yosihisa/WaterRocketComputerVer4/基板/製造ファイル/Specified requirement.docx

# Specified requirement

1. Do not Solder

Do not solder the red pad in the figure below.

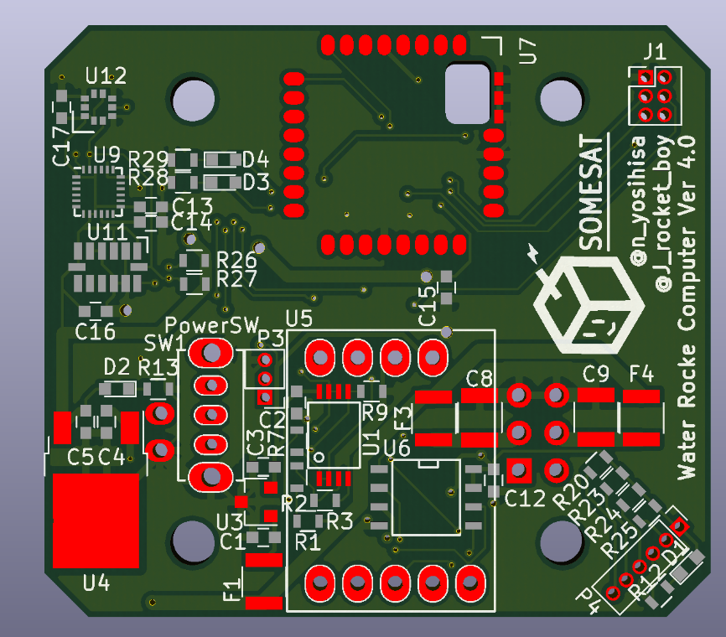
[picture p1: figure]
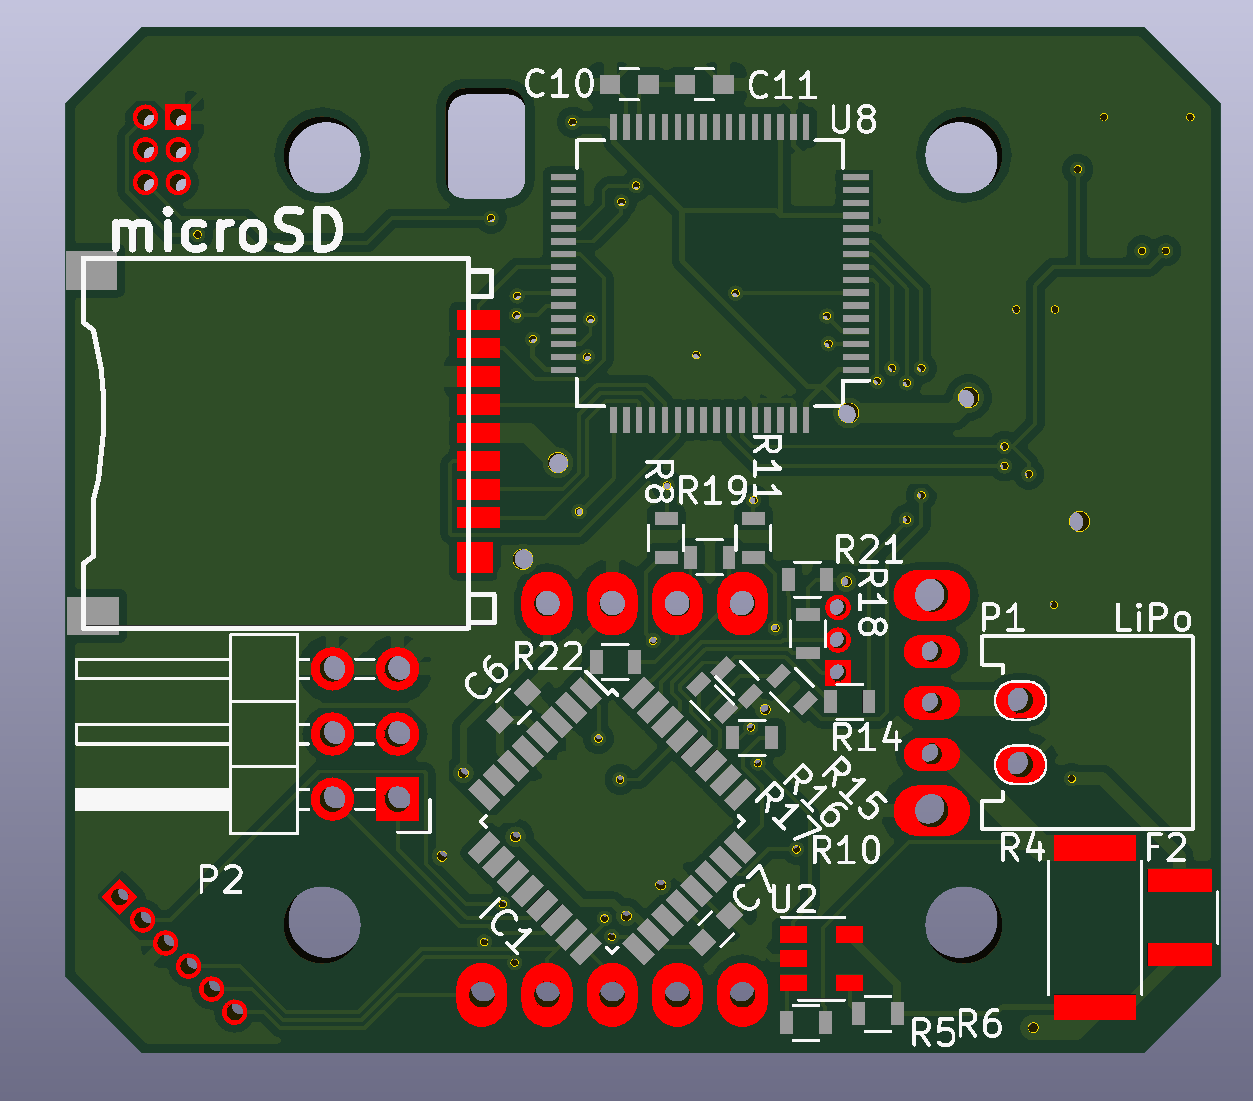
[picture p2: figure]

2. About IC pin mapping

IC's pin assigned as the following. Green pad is 1pin.

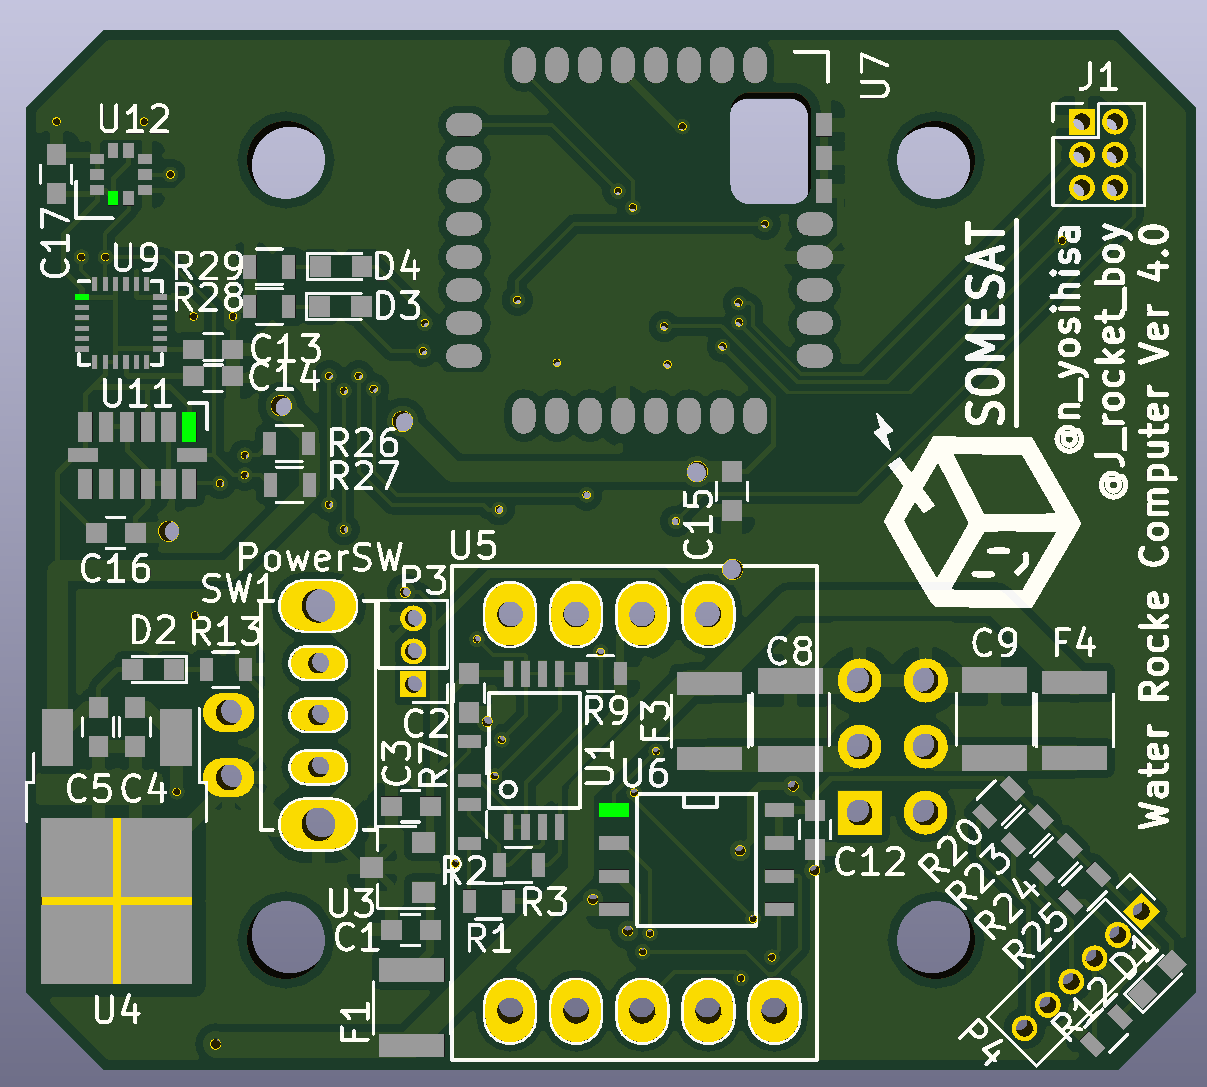
[picture p3: figure]

1

4

8

5

U6

7

14

8 13

6 1

U11

18

13

1

6

24 19

7 12

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
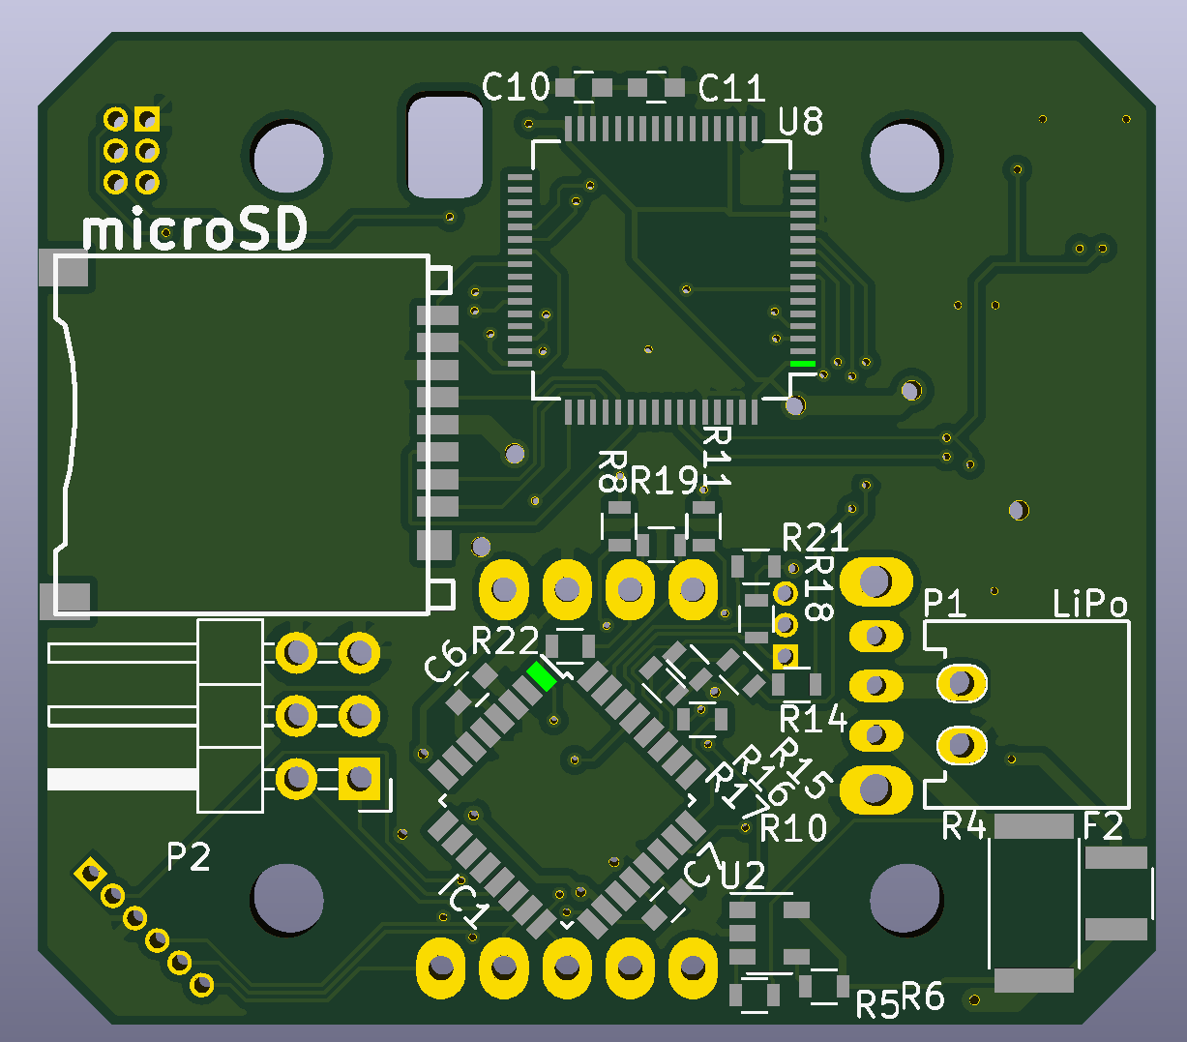
[picture p4: figure]

32 25

9 16

1

8

24

17

IC1

U8

32 17

49 64

33

48

16

1

3. 3D image.

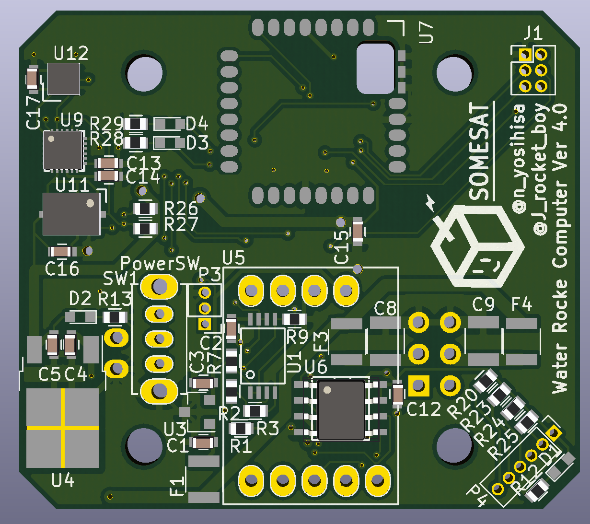
[picture p5: figure]
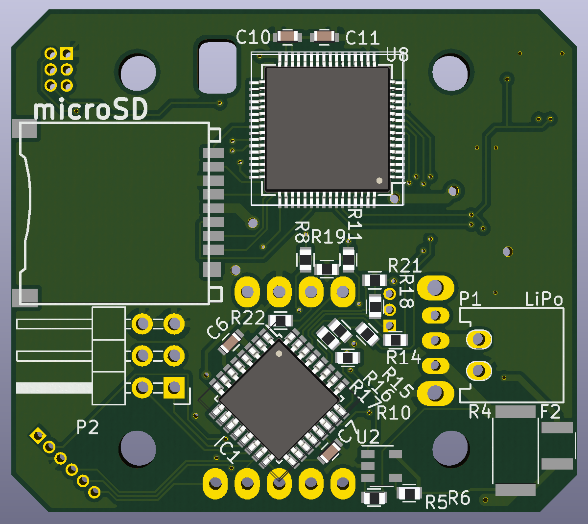
[picture p6: figure]
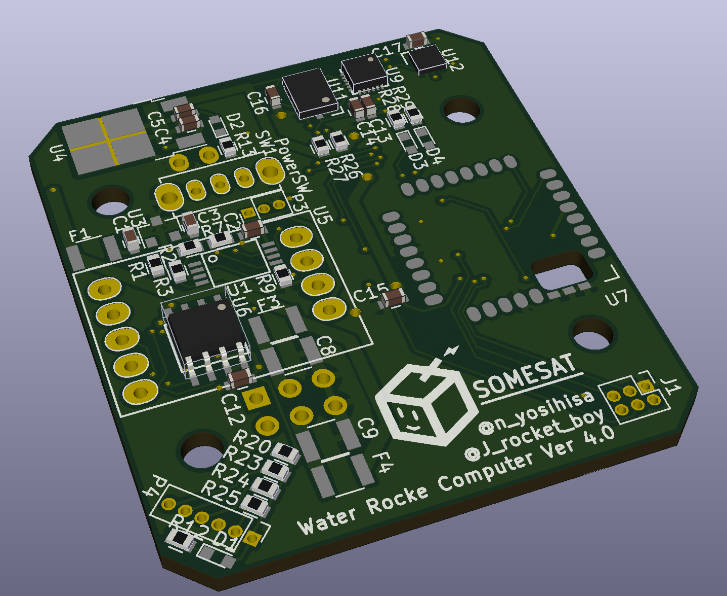
[picture p7: figure]
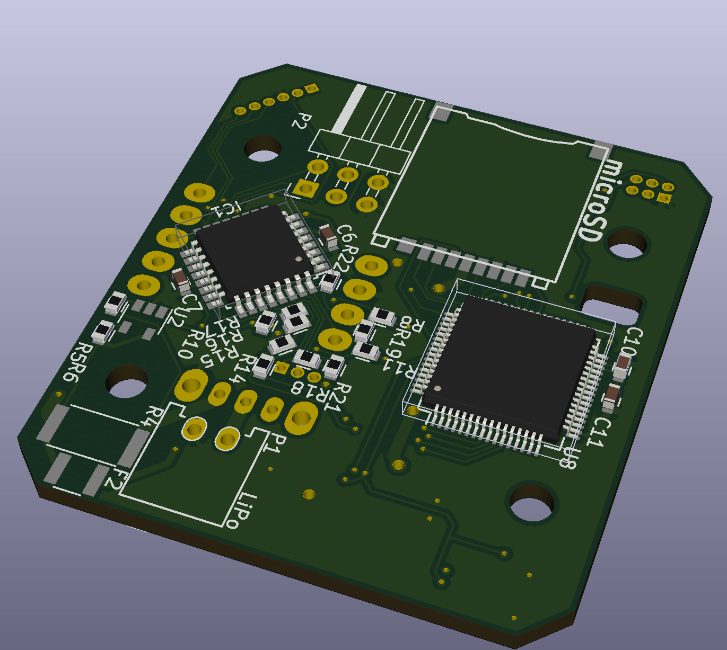
[picture p8: figure]
