yosihisa/WaterRocketComputerVer4/基板/製造ファイル/手実装部品リスト.xlsx

Sheet: Sheet1
version | source | date | tool | number | name | tstamps | title | company | rev | date2 | source3 | number4 | value | ref | value5 | footprint | lib | part | names | tstamps6 | tstamp | datasheet | lib7 | part8 | field | name9 | num | name10 | type | alias | description | docs | fp | logical | uri | code | name11 | ref12 | pin
D | D:/OneDrive/2017能代宇宙イベント/水ロケット/Ver4.0/WRPJ_Ver4.0.sch | 2017/07/07 13:50:01 | Eeschema 4.0.6 | 1 | / | / | Water Rocke Computer Ver 4.0 | SOMESAT | 4 | 2017-06-27 | WRPJ_Ver4.0.sch | 1 | AVR & STM Rocket Control & Logger System
D | D:/OneDrive/2017能代宇宙イベント/水ロケット/Ver4.0/WRPJ_Ver4.0.sch | 2017/07/07 13:50:01 | Eeschema 4.0.6 | 1 | / | / | Water Rocke Computer Ver 4.0 | SOMESAT | 4 | 2017-06-27 | WRPJ_Ver4.0.sch | 2 | Auther1 : @j_rocket_boy
D | D:/OneDrive/2017能代宇宙イベント/水ロケット/Ver4.0/WRPJ_Ver4.0.sch | 2017/07/07 13:50:01 | Eeschema 4.0.6 | 1 | / | / | Water Rocke Computer Ver 4.0 | SOMESAT | 4 | 2017-06-27 | WRPJ_Ver4.0.sch | 3 | Auther2 : @n_yosihisa
D | D:/OneDrive/2017能代宇宙イベント/水ロケット/Ver4.0/WRPJ_Ver4.0.sch | 2017/07/07 13:50:01 | Eeschema 4.0.6 | 1 | / | / | Water Rocke Computer Ver 4.0 | SOMESAT | 4 | 2017-06-27 | WRPJ_Ver4.0.sch | 4
D |  |  |  |  |  |  |  |  |  |  |  |  |  | P1 | LiPo | EH:S2B-EH | conn | CONN_01X02 | / | / | 5951DFFE
D |  |  |  |  |  |  |  |  |  |  |  |  |  | SW1 | PowerSW | mylib_old:SS-12D01-VG4 | WRPJ_Ver4.0-cache | SWITCH_INV | / | / | 5951E0ED
D |  |  |  |  |  |  |  |  |  |  |  |  |  | R4 | 0.01 | Resistors_SMD:R_2512 | device | R | / | / | 5951E17C
D |  |  |  |  |  |  |  |  |  |  |  |  |  | U2 | LT6106 | TO_SOT_Packages_SMD:SOT-23-5 | WRPJ_Ver4.0-rescue | LT6106-RESCUE-WRPJ_Ver4.0 | / | / | 5951E1C7
D |  |  |  |  |  |  |  |  |  |  |  |  |  | R6 | 100 | Resistors_SMD:R_0603 | device | R | / | / | 5951E42E
D |  |  |  |  |  |  |  |  |  |  |  |  |  | R5 | 100 | Resistors_SMD:R_0603 | device | R | / | / | 5951E47D
D |  |  |  |  |  |  |  |  |  |  |  |  |  | R9 | 10k | Resistors_SMD:R_0603 | device | R | / | / | 5951E5F7
D |  |  |  |  |  |  |  |  |  |  |  |  |  | U3 | AP7333-33-SAG-7 | TO_SOT_Packages_SMD:SOT-23 | regul | APE8865NR-33-HF-3 | / | / | 5951E8DC
D |  |  |  |  |  |  |  |  |  |  |  |  |  | C1 | 0.1u | Capacitors_SMD:C_0603 | device | C | / | / | 5951EF63
D |  |  |  |  |  |  |  |  |  |  |  |  |  | C3 | 0.1u | Capacitors_SMD:C_0603 | device | C | / | / | 5951EF8E
D |  |  |  |  |  |  |  |  |  |  |  |  |  | D1 | BUS_VCC | LEDs:LED_0603 | WRPJ_Ver4.0-cache | Led_Small | / | / | 5951F29A
D |  |  |  |  |  |  |  |  |  |  |  |  |  | R12 | 1k | Resistors_SMD:R_0603 | device | R_Small | / | / | 5951F40A
D |  |  |  |  |  |  |  |  |  |  |  |  |  | F1 | 100mA | Resistors_SMD:R_1210 | WRPJ_Ver4.0-cache | F_Small | / | / | 5951F6B5
D |  |  |  |  |  |  |  |  |  |  |  |  |  | U4 | NJM2845DL1-33 | TO_SOT_Packages_SMD:TO-252-2 | regul | LM78M05CT | / | / | 595200C3
D |  |  |  |  |  |  |  |  |  |  |  |  |  | C4 | 0.1u | Capacitors_SMD:C_0603 | device | C | / | / | 595200C9
D |  |  |  |  |  |  |  |  |  |  |  |  |  | C5 | 0.1u | Capacitors_SMD:C_0603 | device | C | / | / | 595200CF
D |  |  |  |  |  |  |  |  |  |  |  |  |  | D2 | MISSION_VCC | LEDs:LED_0603 | WRPJ_Ver4.0-cache | Led_Small | / | / | 595200E4
D |  |  |  |  |  |  |  |  |  |  |  |  |  | R13 | 1k | Resistors_SMD:R_0603 | device | R_Small | / | / | 595200EA
D |  |  |  |  |  |  |  |  |  |  |  |  |  | F2 | 350mA | Resistors_SMD:R_1210 | WRPJ_Ver4.0-cache | F_Small | / | / | 5952010C
D |  |  |  |  |  |  |  |  |  |  |  |  |  | IC1 | ATMEGA328P-A | Housings_QFP:LQFP-32_7x7mm_Pitch0.8mm | WRPJ_Ver4.0-cache | ATMEGA328P-A | / | / | 5952089C
D |  |  |  |  |  |  |  |  |  |  |  |  |  | C6 | 0.1u | Capacitors_SMD:C_0603 | device | C | / | / | 59521C9B
D |  |  |  |  |  |  |  |  |  |  |  |  |  | C7 | 0.1u | Capacitors_SMD:C_0603 | device | C | / | / | 59521CE8
D |  |  |  |  |  |  |  |  |  |  |  |  |  | P4 | AVR_Writer | Pin_Headers:Pin_Header_Straight_1x06_Pitch1.27mm | conn | CONN_01X06 | / | / | 59522732
D |  |  |  |  |  |  |  |  |  |  |  |  |  | P3 | AVR_UART | Pin_Headers:Pin_Header_Straight_1x03_Pitch1.27mm | conn | CONN_01X03 | / | / | 59525C6C
D |  |  |  |  |  |  |  |  |  |  |  |  |  | U5 | AKI-ADXL345 | mylib:AKI-ADXL345 | WRPJ | AKI-ADXL345 | / | / | 59527750
D |  |  |  |  |  |  |  |  |  |  |  |  |  | U6 | FLASH_8 | SMD_Packages:SOIC-8-N | WRPJ | FLASH_8 | / | / | 59527E52
D |  |  |  |  |  |  |  |  |  |  |  |  |  | C12 | 0.1u | Capacitors_SMD:C_0603 | device | C | / | / | 59527FBB
D |  |  |  |  |  |  |  |  |  |  |  |  |  | R24 | 10k | Resistors_SMD:R_0603 | device | R | / | / | 5952BE2E
D |  |  |  |  |  |  |  |  |  |  |  |  |  | R23 | 10k | Resistors_SMD:R_0603 | device | R | / | / | 5952BE8F
D |  |  |  |  |  |  |  |  |  |  |  |  |  | R20 | 10k | Resistors_SMD:R_0603 | device | R | / | / | 5952BEE6
D |  |  |  |  |  |  |  |  |  |  |  |  |  | R18 | 10k | Resistors_SMD:R_0603 | device | R | / | / | 5952C92D
D |  |  |  |  |  |  |  |  |  |  |  |  |  | R21 | 10k | Resistors_SMD:R_0603 | device | R | / | / | 5952C9BA
D |  |  |  |  |  |  |  |  |  |  |  |  |  | R19 | 10k | Resistors_SMD:R_0603 | device | R | / | / | 5952D7E0
D |  |  |  |  |  |  |  |  |  |  |  |  |  | R22 | 10k | Resistors_SMD:R_0603 | device | R | / | / | 5952D7E6
D |  |  |  |  |  |  |  |  |  |  |  |  |  | R16 | 10k | Resistors_SMD:R_0603 | device | R | / | / | 5952E0CD
D |  |  |  |  |  |  |  |  |  |  |  |  |  | R17 | 10k | Resistors_SMD:R_0603 | device | R | / | / | 5952E0D3
D |  |  |  |  |  |  |  |  |  |  |  |  |  | U1 | NJM2732 | mylib:SSOP-8 | linear | OP275 | / | / | 5952F787
D |  |  |  |  |  |  |  |  |  |  |  |  |  | R7 | 1k | Resistors_SMD:R_0603 | device | R | / | / | 59532ACC
D |  |  |  |  |  |  |  |  |  |  |  |  |  | R8 | 1k | Resistors_SMD:R_0603 | device | R | / | / | 59532B8D
D |  |  |  |  |  |  |  |  |  |  |  |  |  | R10 | 1k | Resistors_SMD:R_0603 | device | R | / | / | 59532C10
D |  |  |  |  |  |  |  |  |  |  |  |  |  | R11 | 1k | Resistors_SMD:R_0603 | device | R | / | / | 59532C97
D |  |  |  |  |  |  |  |  |  |  |  |  |  | C2 | 0.1u | Capacitors_SMD:C_0603 | device | C | / | / | 595341D7
D |  |  |  |  |  |  |  |  |  |  |  |  |  | R3 | 10k | Resistors_SMD:R_0603 | device | R | / | / | 595377FD
D |  |  |  |  |  |  |  |  |  |  |  |  |  | R2 | 10k | Resistors_SMD:R_0603 | device | R | / | / | 59537C46
D |  |  |  |  |  |  |  |  |  |  |  |  |  | R1 | 10k | Resistors_SMD:R_0603 | device | R | / | / | 595381FD
D |  |  |  |  |  |  |  |  |  |  |  |  |  | R14 | 1k | Resistors_SMD:R_0603 | device | R | / | / | 5953D6BC
D |  |  |  |  |  |  |  |  |  |  |  |  |  | R15 | 1k | Resistors_SMD:R_0603 | device | R | / | / | 5953D767
D |  |  |  |  |  |  |  |  |  |  |  |  |  | F4 | 1.25A | Resistors_SMD:R_1210 | WRPJ_Ver4.0-cache | F_Small | / | / | 5954E454
D |  |  |  |  |  |  |  |  |  |  |  |  |  | P2 | Servo | Pin_Headers:Pin_Header_Angled_2x03_Pitch2.54mm | conn | CONN_02X03 | / | / | 5955B51D
D |  |  |  |  |  |  |  |  |  |  |  |  |  | C9 | 47u | Capacitors_SMD:C_1210 | device | C_Small | / | / | 59560C42
D |  |  |  |  |  |  |  |  |  |  |  |  |  | F3 | 1.25A | Resistors_SMD:R_1210 | WRPJ_Ver4.0-cache | F_Small | / | / | 5956224F
D |  |  |  |  |  |  |  |  |  |  |  |  |  | C8 | 47u | Capacitors_SMD:C_1210 | device | C_Small | / | / | 59562256
D |  |  |  |  |  |  |  |  |  |  |  |  |  | R25 | 10k | Resistors_SMD:R_0603 | device | R | / | / | 59536F8D
D |  |  |  |  |  |  |  |  |  |  |  |  |  | U8 | STM32F401RCTx | Housings_QFP:LQFP-64_10x10mm_Pitch0.5mm | STM32 | STM32F401RCTx | / | / | 5957A1D2
D |  |  |  |  |  |  |  |  |  |  |  |  |  | C11 | 0.1u | Capacitors_SMD:C_0603 | device | C_Small | / | / | 5957E787
D |  |  |  |  |  |  |  |  |  |  |  |  |  | C10 | 2.2u | Capacitors_SMD:C_0805 | device | C_Small | / | / | 5957E8BA
D |  |  |  |  |  |  |  |  |  |  |  |  |  | U10 | microSD | user:microSD | mylib_CanSat | microSD | / | / | 5958E8EE
D |  |  |  |  |  |  |  |  |  |  |  |  |  | C15 | 0.1u | Capacitors_SMD:C_0603 | device | C_Small | / | / | 595901BF
D |  |  |  |  |  |  |  |  |  |  |  |  |  | U7 | TWE_LITE_SMD | user:TWE-001L-SMD | TWE-Lite | TWE_LITE_SMD | / | / | 59577CEB | DOCUMENTATION
D |  |  |  |  |  |  |  |  |  |  |  |  |  | U9 | MPU-9250 | Housings_DFN_QFN:QFN-24_3x3mm_Pitch0.4mm | user_library | MPU-9250 | / | / | 5957B947
D |  |  |  |  |  |  |  |  |  |  |  |  |  | C13 | 0.1u | Capacitors_SMD:C_0603 | device | C_Small | / | / | 5957CFDC
D |  |  |  |  |  |  |  |  |  |  |  |  |  | C14 | 0.1u | Capacitors_SMD:C_0603 | device | C_Small | / | / | 5957CF15
D |  |  |  |  |  |  |  |  |  |  |  |  |  | U11 | ADXL375 | user:LGA_CC-14-1 | user_library | ADXL375 | / | / | 59585084
D |  |  |  |  |  |  |  |  |  |  |  |  |  | R26 | 4.7k | Resistors_SMD:R_0603 | device | R | / | / | 5958A8C7
D |  |  |  |  |  |  |  |  |  |  |  |  |  | R27 | 4.7k | Resistors_SMD:R_0603 | device | R | / | / | 5958A984
D |  |  |  |  |  |  |  |  |  |  |  |  |  | C16 | 0.1u | Capacitors_SMD:C_0603 | device | C_Small | / | / | 5959014C
D |  |  |  |  |  |  |  |  |  |  |  |  |  | U12 | LPS25HB | user:HLGA-10L | user_library | LPS25HB | / | / | 59591ABD
D |  |  |  |  |  |  |  |  |  |  |  |  |  | C17 | 0.1u | Capacitors_SMD:C_0603 | device | C_Small | / | / | 595954C6
D |  |  |  |  |  |  |  |  |  |  |  |  |  | J1 | SWD | Pin_Headers:Pin_Header_Straight_2x03_Pitch1.27mm | conn | CONN_02X03 | / | / | 5959CB8A
D |  |  |  |  |  |  |  |  |  |  |  |  |  | D3 | LED1 | LEDs:LED_0603 | WRPJ_Ver4.0-cache | Led_Small | / | / | 595E6C8C
D |  |  |  |  |  |  |  |  |  |  |  |  |  | R28 | 1k | Resistors_SMD:R_0603 | device | R_Small | / | / | 595E6C92
D |  |  |  |  |  |  |  |  |  |  |  |  |  | D4 | LED2 | LEDs:LED_0603 | WRPJ_Ver4.0-cache | Led_Small | / | / | 595E72FC
D |  |  |  |  |  |  |  |  |  |  |  |  |  | R29 | 1k | Resistors_SMD:R_0603 | device | R_Small | / | / | 595E7302
D |  |  |  |  |  |  |  |  |  |  |  |  |  |  |  |  |  |  |  |  |  |  | user_library | ADXL375 | U | Reference
D |  |  |  |  |  |  |  |  |  |  |  |  |  |  |  |  |  |  |  |  |  |  | user_library | ADXL375 | ADXL375 | Value
D |  |  |  |  |  |  |  |  |  |  |  |  |  |  |  |  |  |  |  |  |  |  | user_library | ADXL375 |  |  | 1 | VDDIO | power_in
D |  |  |  |  |  |  |  |  |  |  |  |  |  |  |  |  |  |  |  |  |  |  | user_library | ADXL375 |  |  | 2 | GND | power_out
D |  |  |  |  |  |  |  |  |  |  |  |  |  |  |  |  |  |  |  |  |  |  | user_library | ADXL375 |  |  | 3 | RESERVED | passive
D |  |  |  |  |  |  |  |  |  |  |  |  |  |  |  |  |  |  |  |  |  |  | user_library | ADXL375 |  |  | 4 | GND | power_out
D |  |  |  |  |  |  |  |  |  |  |  |  |  |  |  |  |  |  |  |  |  |  | user_library | ADXL375 |  |  | 5 | GND | power_out
D |  |  |  |  |  |  |  |  |  |  |  |  |  |  |  |  |  |  |  |  |  |  | user_library | ADXL375 |  |  | 6 | Vs | power_in
D |  |  |  |  |  |  |  |  |  |  |  |  |  |  |  |  |  |  |  |  |  |  | user_library | ADXL375 |  |  | 7 | CS | passive
D |  |  |  |  |  |  |  |  |  |  |  |  |  |  |  |  |  |  |  |  |  |  | user_library | ADXL375 |  |  | 8 | INT1 | passive
D |  |  |  |  |  |  |  |  |  |  |  |  |  |  |  |  |  |  |  |  |  |  | user_library | ADXL375 |  |  | 9 | INT2 | passive
D |  |  |  |  |  |  |  |  |  |  |  |  |  |  |  |  |  |  |  |  |  |  | user_library | ADXL375 |  |  | 10 | NC | NotConnected
D |  |  |  |  |  |  |  |  |  |  |  |  |  |  |  |  |  |  |  |  |  |  | user_library | ADXL375 |  |  | 11 | RESERVED | passive
D |  |  |  |  |  |  |  |  |  |  |  |  |  |  |  |  |  |  |  |  |  |  | user_library | ADXL375 |  |  | 12 | SDO/ALT_ADDRESS | passive
D |  |  |  |  |  |  |  |  |  |  |  |  |  |  |  |  |  |  |  |  |  |  | user_library | ADXL375 |  |  | 13 | SDA/SDI/SDIO | passive
D |  |  |  |  |  |  |  |  |  |  |  |  |  |  |  |  |  |  |  |  |  |  | user_library | ADXL375 |  |  | 14 | SCL/SCLK | passive
D |  |  |  |  |  |  |  |  |  |  |  |  |  |  |  |  |  |  |  |  |  |  | WRPJ | AKI-ADXL345 | U | Reference
D |  |  |  |  |  |  |  |  |  |  |  |  |  |  |  |  |  |  |  |  |  |  | WRPJ | AKI-ADXL345 | AKI-ADXL345 | Value
D |  |  |  |  |  |  |  |  |  |  |  |  |  |  |  |  |  |  |  |  |  |  | WRPJ | AKI-ADXL345 |  |  | 1 | VDD | power_in
D |  |  |  |  |  |  |  |  |  |  |  |  |  |  |  |  |  |  |  |  |  |  | WRPJ | AKI-ADXL345 |  |  | 2 | GND | power_in
D |  |  |  |  |  |  |  |  |  |  |  |  |  |  |  |  |  |  |  |  |  |  | WRPJ | AKI-ADXL345 |  |  | 3 | Vs | power_in
D |  |  |  |  |  |  |  |  |  |  |  |  |  |  |  |  |  |  |  |  |  |  | WRPJ | AKI-ADXL345 |  |  | 4 | ~CS | input
D |  |  |  |  |  |  |  |  |  |  |  |  |  |  |  |  |  |  |  |  |  |  | WRPJ | AKI-ADXL345 |  |  | 5 | INT1 | output
D |  |  |  |  |  |  |  |  |  |  |  |  |  |  |  |  |  |  |  |  |  |  | WRPJ | AKI-ADXL345 |  |  | 6 | INT2 | output
D |  |  |  |  |  |  |  |  |  |  |  |  |  |  |  |  |  |  |  |  |  |  | WRPJ | AKI-ADXL345 |  |  | 7 | SDO/ALT_ADDRESS | BiDi
D |  |  |  |  |  |  |  |  |  |  |  |  |  |  |  |  |  |  |  |  |  |  | WRPJ | AKI-ADXL345 |  |  | 8 | SDA/SDI/SDIO | BiDi
D |  |  |  |  |  |  |  |  |  |  |  |  |  |  |  |  |  |  |  |  |  |  | WRPJ | AKI-ADXL345 |  |  | 9 | SCL/SCLK | input
D |  |  |  |  |  |  |  |  |  |  |  |  |  |  |  |  |  |  |  |  |  |  | regul | APE8865NR-12-HF-3 | U | Reference |  |  |  |  | 300 mA Low Dropout Voltage Regulator, Fixed Output 1.2V, SOT-23 | http://www.a-powerusa.com/docs/APE8865-3.pdf
D |  |  |  |  |  |  |  |  |  |  |  |  |  |  |  |  |  |  |  |  |  |  | regul | APE8865NR-12-HF-3 | APE8865NR-12-HF-3 | Value |  |  |  |  | 300 mA Low Dropout Voltage Regulator, Fixed Output 1.2V, SOT-23 | http://www.a-powerusa.com/docs/APE8865-3.pdf
D |  |  |  |  |  |  |  |  |  |  |  |  |  |  |  |  |  |  |  |  |  |  | regul | APE8865NR-12-HF-3 | TO_SOT_Packages_SMD:SOT-23 | Footprint |  |  |  |  | 300 mA Low Dropout Voltage Regulator, Fixed Output 1.2V, SOT-23 | http://www.a-powerusa.com/docs/APE8865-3.pdf
D |  |  |  |  |  |  |  |  |  |  |  |  |  |  |  |  |  |  |  |  |  |  | regul | APE8865NR-12-HF-3 |  |  | 1 | VIN | input |  | 300 mA Low Dropout Voltage Regulator, Fixed Output 1.2V, SOT-23 | http://www.a-powerusa.com/docs/APE8865-3.pdf
D |  |  |  |  |  |  |  |  |  |  |  |  |  |  |  |  |  |  |  |  |  |  | regul | APE8865NR-12-HF-3 |  |  | 2 | VOUT | power_out |  | 300 mA Low Dropout Voltage Regulator, Fixed Output 1.2V, SOT-23 | http://www.a-powerusa.com/docs/APE8865-3.pdf
D |  |  |  |  |  |  |  |  |  |  |  |  |  |  |  |  |  |  |  |  |  |  | regul | APE8865NR-12-HF-3 |  |  | 3 | GND | power_in |  | 300 mA Low Dropout Voltage Regulator, Fixed Output 1.2V, SOT-23 | http://www.a-powerusa.com/docs/APE8865-3.pdf
D |  |  |  |  |  |  |  |  |  |  |  |  |  |  |  |  |  |  |  |  |  |  | regul | APE8865NR-12-HF-3 |  |  |  |  |  | APE8865NR-15-HF-3 | 300 mA Low Dropout Voltage Regulator, Fixed Output 1.2V, SOT-23 | http://www.a-powerusa.com/docs/APE8865-3.pdf
D |  |  |  |  |  |  |  |  |  |  |  |  |  |  |  |  |  |  |  |  |  |  | regul | APE8865NR-12-HF-3 |  |  |  |  |  | APE8865NR-16-HF-3 | 300 mA Low Dropout Voltage Regulator, Fixed Output 1.2V, SOT-23 | http://www.a-powerusa.com/docs/APE8865-3.pdf
D |  |  |  |  |  |  |  |  |  |  |  |  |  |  |  |  |  |  |  |  |  |  | regul | APE8865NR-12-HF-3 |  |  |  |  |  | APE8865NR-17-HF-3 | 300 mA Low Dropout Voltage Regulator, Fixed Output 1.2V, SOT-23 | http://www.a-powerusa.com/docs/APE8865-3.pdf
D |  |  |  |  |  |  |  |  |  |  |  |  |  |  |  |  |  |  |  |  |  |  | regul | APE8865NR-12-HF-3 |  |  |  |  |  | APE8865NR-18-HF-3 | 300 mA Low Dropout Voltage Regulator, Fixed Output 1.2V, SOT-23 | http://www.a-powerusa.com/docs/APE8865-3.pdf
D |  |  |  |  |  |  |  |  |  |  |  |  |  |  |  |  |  |  |  |  |  |  | regul | APE8865NR-12-HF-3 |  |  |  |  |  | APE8865NR-19-HF-3 | 300 mA Low Dropout Voltage Regulator, Fixed Output 1.2V, SOT-23 | http://www.a-powerusa.com/docs/APE8865-3.pdf
D |  |  |  |  |  |  |  |  |  |  |  |  |  |  |  |  |  |  |  |  |  |  | regul | APE8865NR-12-HF-3 |  |  |  |  |  | APE8865NR-20-HF-3 | 300 mA Low Dropout Voltage Regulator, Fixed Output 1.2V, SOT-23 | http://www.a-powerusa.com/docs/APE8865-3.pdf
D |  |  |  |  |  |  |  |  |  |  |  |  |  |  |  |  |  |  |  |  |  |  | regul | APE8865NR-12-HF-3 |  |  |  |  |  | APE8865NR-21-HF-3 | 300 mA Low Dropout Voltage Regulator, Fixed Output 1.2V, SOT-23 | http://www.a-powerusa.com/docs/APE8865-3.pdf
D |  |  |  |  |  |  |  |  |  |  |  |  |  |  |  |  |  |  |  |  |  |  | regul | APE8865NR-12-HF-3 |  |  |  |  |  | APE8865NR-22-HF-3 | 300 mA Low Dropout Voltage Regulator, Fixed Output 1.2V, SOT-23 | http://www.a-powerusa.com/docs/APE8865-3.pdf
D |  |  |  |  |  |  |  |  |  |  |  |  |  |  |  |  |  |  |  |  |  |  | regul | APE8865NR-12-HF-3 |  |  |  |  |  | APE8865NR-23-HF-3 | 300 mA Low Dropout Voltage Regulator, Fixed Output 1.2V, SOT-23 | http://www.a-powerusa.com/docs/APE8865-3.pdf
D |  |  |  |  |  |  |  |  |  |  |  |  |  |  |  |  |  |  |  |  |  |  | regul | APE8865NR-12-HF-3 |  |  |  |  |  | APE8865NR-24-HF-3 | 300 mA Low Dropout Voltage Regulator, Fixed Output 1.2V, SOT-23 | http://www.a-powerusa.com/docs/APE8865-3.pdf
D |  |  |  |  |  |  |  |  |  |  |  |  |  |  |  |  |  |  |  |  |  |  | regul | APE8865NR-12-HF-3 |  |  |  |  |  | APE8865NR-25-HF-3 | 300 mA Low Dropout Voltage Regulator, Fixed Output 1.2V, SOT-23 | http://www.a-powerusa.com/docs/APE8865-3.pdf
D |  |  |  |  |  |  |  |  |  |  |  |  |  |  |  |  |  |  |  |  |  |  | regul | APE8865NR-12-HF-3 |  |  |  |  |  | APE8865NR-26-HF-3 | 300 mA Low Dropout Voltage Regulator, Fixed Output 1.2V, SOT-23 | http://www.a-powerusa.com/docs/APE8865-3.pdf
D |  |  |  |  |  |  |  |  |  |  |  |  |  |  |  |  |  |  |  |  |  |  | regul | APE8865NR-12-HF-3 |  |  |  |  |  | APE8865NR-27-HF-3 | 300 mA Low Dropout Voltage Regulator, Fixed Output 1.2V, SOT-23 | http://www.a-powerusa.com/docs/APE8865-3.pdf
D |  |  |  |  |  |  |  |  |  |  |  |  |  |  |  |  |  |  |  |  |  |  | regul | APE8865NR-12-HF-3 |  |  |  |  |  | APE8865NR-28-HF-3 | 300 mA Low Dropout Voltage Regulator, Fixed Output 1.2V, SOT-23 | http://www.a-powerusa.com/docs/APE8865-3.pdf
D |  |  |  |  |  |  |  |  |  |  |  |  |  |  |  |  |  |  |  |  |  |  | regul | APE8865NR-12-HF-3 |  |  |  |  |  | APE8865NR-29-HF-3 | 300 mA Low Dropout Voltage Regulator, Fixed Output 1.2V, SOT-23 | http://www.a-powerusa.com/docs/APE8865-3.pdf
D |  |  |  |  |  |  |  |  |  |  |  |  |  |  |  |  |  |  |  |  |  |  | regul | APE8865NR-12-HF-3 |  |  |  |  |  | APE8865NR-30-HF-3 | 300 mA Low Dropout Voltage Regulator, Fixed Output 1.2V, SOT-23 | http://www.a-powerusa.com/docs/APE8865-3.pdf
D |  |  |  |  |  |  |  |  |  |  |  |  |  |  |  |  |  |  |  |  |  |  | regul | APE8865NR-12-HF-3 |  |  |  |  |  | APE8865NR-31-HF-3 | 300 mA Low Dropout Voltage Regulator, Fixed Output 1.2V, SOT-23 | http://www.a-powerusa.com/docs/APE8865-3.pdf
D |  |  |  |  |  |  |  |  |  |  |  |  |  |  |  |  |  |  |  |  |  |  | regul | APE8865NR-12-HF-3 |  |  |  |  |  | APE8865NR-32-HF-3 | 300 mA Low Dropout Voltage Regulator, Fixed Output 1.2V, SOT-23 | http://www.a-powerusa.com/docs/APE8865-3.pdf
D |  |  |  |  |  |  |  |  |  |  |  |  |  |  |  |  |  |  |  |  |  |  | regul | APE8865NR-12-HF-3 |  |  |  |  |  | APE8865NR-33-HF-3 | 300 mA Low Dropout Voltage Regulator, Fixed Output 1.2V, SOT-23 | http://www.a-powerusa.com/docs/APE8865-3.pdf
D |  |  |  |  |  |  |  |  |  |  |  |  |  |  |  |  |  |  |  |  |  |  | regul | APE8865NR-12-HF-3 |  |  |  |  |  |  | 300 mA Low Dropout Voltage Regulator, Fixed Output 1.2V, SOT-23 | http://www.a-powerusa.com/docs/APE8865-3.pdf | SOT*
D |  |  |  |  |  |  |  |  |  |  |  |  |  |  |  |  |  |  |  |  |  |  | WRPJ_Ver4.0-cache | ATMEGA168A-A | IC | Reference
D |  |  |  |  |  |  |  |  |  |  |  |  |  |  |  |  |  |  |  |  |  |  | WRPJ_Ver4.0-cache | ATMEGA168A-A | ATMEGA168A-A | Value
D |  |  |  |  |  |  |  |  |  |  |  |  |  |  |  |  |  |  |  |  |  |  | WRPJ_Ver4.0-cache | ATMEGA168A-A | TQFP32 | Footprint
D |  |  |  |  |  |  |  |  |  |  |  |  |  |  |  |  |  |  |  |  |  |  | WRPJ_Ver4.0-cache | ATMEGA168A-A |  |  | 1 | (PCINT19/OC2B/INT1)PD3 | BiDi
D |  |  |  |  |  |  |  |  |  |  |  |  |  |  |  |  |  |  |  |  |  |  | WRPJ_Ver4.0-cache | ATMEGA168A-A |  |  | 2 | (PCINT20/XCK/T0)PD4 | BiDi
D |  |  |  |  |  |  |  |  |  |  |  |  |  |  |  |  |  |  |  |  |  |  | WRPJ_Ver4.0-cache | ATMEGA168A-A |  |  | 3 | GND | power_in
D |  |  |  |  |  |  |  |  |  |  |  |  |  |  |  |  |  |  |  |  |  |  | WRPJ_Ver4.0-cache | ATMEGA168A-A |  |  | 4 | VCC | power_in
D |  |  |  |  |  |  |  |  |  |  |  |  |  |  |  |  |  |  |  |  |  |  | WRPJ_Ver4.0-cache | ATMEGA168A-A |  |  | 5 | GND | power_in
D |  |  |  |  |  |  |  |  |  |  |  |  |  |  |  |  |  |  |  |  |  |  | WRPJ_Ver4.0-cache | ATMEGA168A-A |  |  | 6 | VCC | power_in
D |  |  |  |  |  |  |  |  |  |  |  |  |  |  |  |  |  |  |  |  |  |  | WRPJ_Ver4.0-cache | ATMEGA168A-A |  |  | 7 | (PCINT6/XTAL1/TOSC1)PB6 | BiDi
D |  |  |  |  |  |  |  |  |  |  |  |  |  |  |  |  |  |  |  |  |  |  | WRPJ_Ver4.0-cache | ATMEGA168A-A |  |  | 8 | (PCINT7/XTAL2/TOSC2)PB7 | BiDi
D |  |  |  |  |  |  |  |  |  |  |  |  |  |  |  |  |  |  |  |  |  |  | WRPJ_Ver4.0-cache | ATMEGA168A-A |  |  | 9 | (PCINT21/OC0B/T1)PD5 | BiDi
D |  |  |  |  |  |  |  |  |  |  |  |  |  |  |  |  |  |  |  |  |  |  | WRPJ_Ver4.0-cache | ATMEGA168A-A |  |  | 10 | (PCINT22/OC0A/AIN0)PD6 | BiDi
D |  |  |  |  |  |  |  |  |  |  |  |  |  |  |  |  |  |  |  |  |  |  | WRPJ_Ver4.0-cache | ATMEGA168A-A |  |  | 11 | (PCINT23/AIN1)PD7 | BiDi
D |  |  |  |  |  |  |  |  |  |  |  |  |  |  |  |  |  |  |  |  |  |  | WRPJ_Ver4.0-cache | ATMEGA168A-A |  |  | 12 | (PCINT0/CLKO/ICP1)PB0 | BiDi
D |  |  |  |  |  |  |  |  |  |  |  |  |  |  |  |  |  |  |  |  |  |  | WRPJ_Ver4.0-cache | ATMEGA168A-A |  |  | 13 | (PCINT1/OC1A)PB1 | BiDi
D |  |  |  |  |  |  |  |  |  |  |  |  |  |  |  |  |  |  |  |  |  |  | WRPJ_Ver4.0-cache | ATMEGA168A-A |  |  | 14 | (PCINT2/OC1B/~SS~)PB2 | BiDi
D |  |  |  |  |  |  |  |  |  |  |  |  |  |  |  |  |  |  |  |  |  |  | WRPJ_Ver4.0-cache | ATMEGA168A-A |  |  | 15 | (PCINT3/OC2A/MOSI)PB3 | BiDi
D |  |  |  |  |  |  |  |  |  |  |  |  |  |  |  |  |  |  |  |  |  |  | WRPJ_Ver4.0-cache | ATMEGA168A-A |  |  | 16 | (PCINT4/MISO)PB4 | BiDi
D |  |  |  |  |  |  |  |  |  |  |  |  |  |  |  |  |  |  |  |  |  |  | WRPJ_Ver4.0-cache | ATMEGA168A-A |  |  | 17 | (PCINT5/SCK)PB5 | BiDi
D |  |  |  |  |  |  |  |  |  |  |  |  |  |  |  |  |  |  |  |  |  |  | WRPJ_Ver4.0-cache | ATMEGA168A-A |  |  | 18 | AVCC | power_in
D |  |  |  |  |  |  |  |  |  |  |  |  |  |  |  |  |  |  |  |  |  |  | WRPJ_Ver4.0-cache | ATMEGA168A-A |  |  | 19 | ADC6 | input
D |  |  |  |  |  |  |  |  |  |  |  |  |  |  |  |  |  |  |  |  |  |  | WRPJ_Ver4.0-cache | ATMEGA168A-A |  |  | 20 | AREF | BiDi
D |  |  |  |  |  |  |  |  |  |  |  |  |  |  |  |  |  |  |  |  |  |  | WRPJ_Ver4.0-cache | ATMEGA168A-A |  |  | 21 | GND | power_in
D |  |  |  |  |  |  |  |  |  |  |  |  |  |  |  |  |  |  |  |  |  |  | WRPJ_Ver4.0-cache | ATMEGA168A-A |  |  | 22 | ADC7 | input
D |  |  |  |  |  |  |  |  |  |  |  |  |  |  |  |  |  |  |  |  |  |  | WRPJ_Ver4.0-cache | ATMEGA168A-A |  |  | 23 | (PCINT8/ADC0)PC0 | BiDi
D |  |  |  |  |  |  |  |  |  |  |  |  |  |  |  |  |  |  |  |  |  |  | WRPJ_Ver4.0-cache | ATMEGA168A-A |  |  | 24 | (PCINT9/ADC1)PC1 | BiDi
D |  |  |  |  |  |  |  |  |  |  |  |  |  |  |  |  |  |  |  |  |  |  | WRPJ_Ver4.0-cache | ATMEGA168A-A |  |  | 25 | (PCINT10/ADC2)PC2 | BiDi
D |  |  |  |  |  |  |  |  |  |  |  |  |  |  |  |  |  |  |  |  |  |  | WRPJ_Ver4.0-cache | ATMEGA168A-A |  |  | 26 | (PCINT11/ADC3)PC3 | BiDi
D |  |  |  |  |  |  |  |  |  |  |  |  |  |  |  |  |  |  |  |  |  |  | WRPJ_Ver4.0-cache | ATMEGA168A-A |  |  | 27 | (PCINT12/SDA/ADC4)PC4 | BiDi
D |  |  |  |  |  |  |  |  |  |  |  |  |  |  |  |  |  |  |  |  |  |  | WRPJ_Ver4.0-cache | ATMEGA168A-A |  |  | 28 | (PCINT13/SCL/ADC5)PC5 | BiDi
D |  |  |  |  |  |  |  |  |  |  |  |  |  |  |  |  |  |  |  |  |  |  | WRPJ_Ver4.0-cache | ATMEGA168A-A |  |  | 29 | (PCINT14/~RESET~)PC6 | BiDi
D |  |  |  |  |  |  |  |  |  |  |  |  |  |  |  |  |  |  |  |  |  |  | WRPJ_Ver4.0-cache | ATMEGA168A-A |  |  | 30 | (PCINT16/RXD)PD0 | BiDi
D |  |  |  |  |  |  |  |  |  |  |  |  |  |  |  |  |  |  |  |  |  |  | WRPJ_Ver4.0-cache | ATMEGA168A-A |  |  | 31 | (PCINT17/TXD)PD1 | BiDi
D |  |  |  |  |  |  |  |  |  |  |  |  |  |  |  |  |  |  |  |  |  |  | WRPJ_Ver4.0-cache | ATMEGA168A-A |  |  | 32 | (PCINT18/INT0)PD2 | BiDi
D |  |  |  |  |  |  |  |  |  |  |  |  |  |  |  |  |  |  |  |  |  |  | WRPJ_Ver4.0-cache | ATMEGA168A-A |  |  |  |  |  | ATMEGA48A-A
D |  |  |  |  |  |  |  |  |  |  |  |  |  |  |  |  |  |  |  |  |  |  | WRPJ_Ver4.0-cache | ATMEGA168A-A |  |  |  |  |  | ATMEGA48PA-A
D |  |  |  |  |  |  |  |  |  |  |  |  |  |  |  |  |  |  |  |  |  |  | WRPJ_Ver4.0-cache | ATMEGA168A-A |  |  |  |  |  | ATMEGA88A-A
D |  |  |  |  |  |  |  |  |  |  |  |  |  |  |  |  |  |  |  |  |  |  | WRPJ_Ver4.0-cache | ATMEGA168A-A |  |  |  |  |  | ATMEGA88PA-A
D |  |  |  |  |  |  |  |  |  |  |  |  |  |  |  |  |  |  |  |  |  |  | WRPJ_Ver4.0-cache | ATMEGA168A-A |  |  |  |  |  | ATMEGA168PA-A
D |  |  |  |  |  |  |  |  |  |  |  |  |  |  |  |  |  |  |  |  |  |  | WRPJ_Ver4.0-cache | ATMEGA168A-A |  |  |  |  |  | ATMEGA328-A
D |  |  |  |  |  |  |  |  |  |  |  |  |  |  |  |  |  |  |  |  |  |  | WRPJ_Ver4.0-cache | ATMEGA168A-A |  |  |  |  |  | ATMEGA328P-A
D |  |  |  |  |  |  |  |  |  |  |  |  |  |  |  |  |  |  |  |  |  |  | device | C | C | Reference |  |  |  |  | Unpolarized capacitor
D |  |  |  |  |  |  |  |  |  |  |  |  |  |  |  |  |  |  |  |  |  |  | device | C | C | Value |  |  |  |  | Unpolarized capacitor
D |  |  |  |  |  |  |  |  |  |  |  |  |  |  |  |  |  |  |  |  |  |  | device | C |  |  | 1 | ~ | passive |  | Unpolarized capacitor
D |  |  |  |  |  |  |  |  |  |  |  |  |  |  |  |  |  |  |  |  |  |  | device | C |  |  | 2 | ~ | passive |  | Unpolarized capacitor
D |  |  |  |  |  |  |  |  |  |  |  |  |  |  |  |  |  |  |  |  |  |  | device | C |  |  |  |  |  |  | Unpolarized capacitor |  | C_*
D |  |  |  |  |  |  |  |  |  |  |  |  |  |  |  |  |  |  |  |  |  |  | conn | CONN_01X02 | J | Reference |  |  |  |  | Connector, single row, 01x02, pin header
D |  |  |  |  |  |  |  |  |  |  |  |  |  |  |  |  |  |  |  |  |  |  | conn | CONN_01X02 | CONN_01X02 | Value |  |  |  |  | Connector, single row, 01x02, pin header
D |  |  |  |  |  |  |  |  |  |  |  |  |  |  |  |  |  |  |  |  |  |  | conn | CONN_01X02 |  |  | 1 | P1 | passive |  | Connector, single row, 01x02, pin header
D |  |  |  |  |  |  |  |  |  |  |  |  |  |  |  |  |  |  |  |  |  |  | conn | CONN_01X02 |  |  | 2 | P2 | passive |  | Connector, single row, 01x02, pin header
D |  |  |  |  |  |  |  |  |  |  |  |  |  |  |  |  |  |  |  |  |  |  | conn | CONN_01X02 |  |  |  |  |  |  | Connector, single row, 01x02, pin header |  | Pin_Header_Straight_1X*
D |  |  |  |  |  |  |  |  |  |  |  |  |  |  |  |  |  |  |  |  |  |  | conn | CONN_01X02 |  |  |  |  |  |  | Connector, single row, 01x02, pin header |  | Pin_Header_Angled_1X*
D |  |  |  |  |  |  |  |  |  |  |  |  |  |  |  |  |  |  |  |  |  |  | conn | CONN_01X02 |  |  |  |  |  |  | Connector, single row, 01x02, pin header |  | Socket_Strip_Straight_1X*
D |  |  |  |  |  |  |  |  |  |  |  |  |  |  |  |  |  |  |  |  |  |  | conn | CONN_01X02 |  |  |  |  |  |  | Connector, single row, 01x02, pin header |  | Socket_Strip_Angled_1X*
D |  |  |  |  |  |  |  |  |  |  |  |  |  |  |  |  |  |  |  |  |  |  | conn | CONN_01X03 | J | Reference |  |  |  |  | Connector, single row, 01x03, pin header
D |  |  |  |  |  |  |  |  |  |  |  |  |  |  |  |  |  |  |  |  |  |  | conn | CONN_01X03 | CONN_01X03 | Value |  |  |  |  | Connector, single row, 01x03, pin header
D |  |  |  |  |  |  |  |  |  |  |  |  |  |  |  |  |  |  |  |  |  |  | conn | CONN_01X03 |  |  | 1 | P1 | passive |  | Connector, single row, 01x03, pin header
D |  |  |  |  |  |  |  |  |  |  |  |  |  |  |  |  |  |  |  |  |  |  | conn | CONN_01X03 |  |  | 2 | P2 | passive |  | Connector, single row, 01x03, pin header
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
D |  |  |  |  |  |  |  |  |  |  |  |  |  |  |  |  |  |  |  |  |  |  | conn | CONN_02X03 |  |  |  |  |  |  | Connector, double row, 02x03, pin header |  | Pin_Header_Angled_2X*
D |  |  |  |  |  |  |  |  |  |  |  |  |  |  |  |  |  |  |  |  |  |  | conn | CONN_02X03 |  |  |  |  |  |  | Connector, double row, 02x03, pin header |  | Socket_Strip_Straight_2X*
D |  |  |  |  |  |  |  |  |  |  |  |  |  |  |  |  |  |  |  |  |  |  | conn | CONN_02X03 |  |  |  |  |  |  | Connector, double row, 02x03, pin header |  | Socket_Strip_Angled_2X*
D |  |  |  |  |  |  |  |  |  |  |  |  |  |  |  |  |  |  |  |  |  |  | conn | CONN_02X03 |  |  |  |  |  |  | Connector, double row, 02x03, pin header |  | IDC_Header_Straight_*
D |  |  |  |  |  |  |  |  |  |  |  |  |  |  |  |  |  |  |  |  |  |  | device | C_Small | C | Reference |  |  |  |  | Unpolarized capacitor
D |  |  |  |  |  |  |  |  |  |  |  |  |  |  |  |  |  |  |  |  |  |  | device | C_Small | C_Small | Value |  |  |  |  | Unpolarized capacitor
D |  |  |  |  |  |  |  |  |  |  |  |  |  |  |  |  |  |  |  |  |  |  | device | C_Small |  |  | 1 | ~ | passive |  | Unpolarized capacitor
D |  |  |  |  |  |  |  |  |  |  |  |  |  |  |  |  |  |  |  |  |  |  | device | C_Small |  |  | 2 | ~ | passive |  | Unpolarized capacitor
D |  |  |  |  |  |  |  |  |  |  |  |  |  |  |  |  |  |  |  |  |  |  | device | C_Small |  |  |  |  |  |  | Unpolarized capacitor |  | C_*
D |  |  |  |  |  |  |  |  |  |  |  |  |  |  |  |  |  |  |  |  |  |  | WRPJ | FLASH_8 | U | Reference
D |  |  |  |  |  |  |  |  |  |  |  |  |  |  |  |  |  |  |  |  |  |  | WRPJ | FLASH_8 | FLASH_8 | Value
D |  |  |  |  |  |  |  |  |  |  |  |  |  |  |  |  |  |  |  |  |  |  | WRPJ | FLASH_8 |  |  | 1 | ~SELECT | input
D |  |  |  |  |  |  |  |  |  |  |  |  |  |  |  |  |  |  |  |  |  |  | WRPJ | FLASH_8 |  |  | 2 | DATA_OUTPUT | output
D |  |  |  |  |  |  |  |  |  |  |  |  |  |  |  |  |  |  |  |  |  |  | WRPJ | FLASH_8 |  |  | 3 | ~WRITE_PROTECT | input
D |  |  |  |  |  |  |  |  |  |  |  |  |  |  |  |  |  |  |  |  |  |  | WRPJ | FLASH_8 |  |  | 4 | Vss | power_in
D |  |  |  |  |  |  |  |  |  |  |  |  |  |  |  |  |  |  |  |  |  |  | WRPJ | FLASH_8 |  |  | 5 | DATA_INPUT | input
D |  |  |  |  |  |  |  |  |  |  |  |  |  |  |  |  |  |  |  |  |  |  | WRPJ | FLASH_8 |  |  | 6 | CLOCK | input
D |  |  |  |  |  |  |  |  |  |  |  |  |  |  |  |  |  |  |  |  |  |  | WRPJ | FLASH_8 |  |  | 7 | ~HOLD | input
D |  |  |  |  |  |  |  |  |  |  |  |  |  |  |  |  |  |  |  |  |  |  | WRPJ | FLASH_8 |  |  | 8 | Vcc | power_in
D |  |  |  |  |  |  |  |  |  |  |  |  |  |  |  |  |  |  |  |  |  |  | WRPJ_Ver4.0-cache | F_Small | F | Reference
D |  |  |  |  |  |  |  |  |  |  |  |  |  |  |  |  |  |  |  |  |  |  | WRPJ_Ver4.0-cache | F_Small | F_Small | Value
D |  |  |  |  |  |  |  |  |  |  |  |  |  |  |  |  |  |  |  |  |  |  | WRPJ_Ver4.0-cache | F_Small |  |  | 1 | ~ | passive
D |  |  |  |  |  |  |  |  |  |  |  |  |  |  |  |  |  |  |  |  |  |  | WRPJ_Ver4.0-cache | F_Small |  |  | 2 | ~ | passive
D |  |  |  |  |  |  |  |  |  |  |  |  |  |  |  |  |  |  |  |  |  |  | WRPJ_Ver4.0-cache | F_Small |  |  |  |  |  |  |  |  | CP*
D |  |  |  |  |  |  |  |  |  |  |  |  |  |  |  |  |  |  |  |  |  |  | WRPJ_Ver4.0-cache | F_Small |  |  |  |  |  |  |  |  | SM*
D |  |  |  |  |  |  |  |  |  |  |  |  |  |  |  |  |  |  |  |  |  |  | regul | LM78M05CT | U | Reference |  |  |  |  | Positive 0.5A 35V Linear Regulator, Fixed Output 5V, TO-220 | http://www.fairchildsemi.com/ds/LM/LM78M05.pdf
D |  |  |  |  |  |  |  |  |  |  |  |  |  |  |  |  |  |  |  |  |  |  | regul | LM78M05CT | LM78M05CT | Value |  |  |  |  | Positive 0.5A 35V Linear Regulator, Fixed Output 5V, TO-220 | http://www.fairchildsemi.com/ds/LM/LM78M05.pdf
D |  |  |  |  |  |  |  |  |  |  |  |  |  |  |  |  |  |  |  |  |  |  | regul | LM78M05CT | TO_SOT_Packages_THT:TO-220_Vertical | Footprint |  |  |  |  | Positive 0.5A 35V Linear Regulator, Fixed Output 5V, TO-220 | http://www.fairchildsemi.com/ds/LM/LM78M05.pdf
D |  |  |  |  |  |  |  |  |  |  |  |  |  |  |  |  |  |  |  |  |  |  | regul | LM78M05CT |  |  | 1 | IN | input |  | Positive 0.5A 35V Linear Regulator, Fixed Output 5V, TO-220 | http://www.fairchildsemi.com/ds/LM/LM78M05.pdf
D |  |  |  |  |  |  |  |  |  |  |  |  |  |  |  |  |  |  |  |  |  |  | regul | LM78M05CT |  |  | 2 | GND | power_in |  | Positive 0.5A 35V Linear Regulator, Fixed Output 5V, TO-220 | http://www.fairchildsemi.com/ds/LM/LM78M05.pdf
D |  |  |  |  |  |  |  |  |  |  |  |  |  |  |  |  |  |  |  |  |  |  | regul | LM78M05CT |  |  | 3 | OUT | power_out |  | Positive 0.5A 35V Linear Regulator, Fixed Output 5V, TO-220 | http://www.fairchildsemi.com/ds/LM/LM78M05.pdf
D |  |  |  |  |  |  |  |  |  |  |  |  |  |  |  |  |  |  |  |  |  |  | regul | LM78M05CT |  |  |  |  |  |  | Positive 0.5A 35V Linear Regulator, Fixed Output 5V, TO-220 | http://www.fairchildsemi.com/ds/LM/LM78M05.pdf | TO*
D |  |  |  |  |  |  |  |  |  |  |  |  |  |  |  |  |  |  |  |  |  |  | user_library | LPS25HB | U | Reference
D |  |  |  |  |  |  |  |  |  |  |  |  |  |  |  |  |  |  |  |  |  |  | user_library | LPS25HB | LPS25HB | Value
D |  |  |  |  |  |  |  |  |  |  |  |  |  |  |  |  |  |  |  |  |  |  | user_library | LPS25HB |  |  | 1 | VIO | power_in
D |  |  |  |  |  |  |  |  |  |  |  |  |  |  |  |  |  |  |  |  |  |  | user_library | LPS25HB |  |  | 2 | SCL | passive
D |  |  |  |  |  |  |  |  |  |  |  |  |  |  |  |  |  |  |  |  |  |  | user_library | LPS25HB |  |  | 3 | RES | passive
D |  |  |  |  |  |  |  |  |  |  |  |  |  |  |  |  |  |  |  |  |  |  | user_library | LPS25HB |  |  | 4 | SDA | passive
D |  |  |  |  |  |  |  |  |  |  |  |  |  |  |  |  |  |  |  |  |  |  | user_library | LPS25HB |  |  | 5 | SDO | passive
D |  |  |  |  |  |  |  |  |  |  |  |  |  |  |  |  |  |  |  |  |  |  | user_library | LPS25HB |  |  | 6 | CS | passive
D |  |  |  |  |  |  |  |  |  |  |  |  |  |  |  |  |  |  |  |  |  |  | user_library | LPS25HB |  |  | 7 | INT1 | passive
D |  |  |  |  |  |  |  |  |  |  |  |  |  |  |  |  |  |  |  |  |  |  | user_library | LPS25HB |  |  | 8 | GND | power_out
D |  |  |  |  |  |  |  |  |  |  |  |  |  |  |  |  |  |  |  |  |  |  | user_library | LPS25HB |  |  | 9 | GND | power_out
D |  |  |  |  |  |  |  |  |  |  |  |  |  |  |  |  |  |  |  |  |  |  | user_library | LPS25HB |  |  | 10 | VDD | power_in
D |  |  |  |  |  |  |  |  |  |  |  |  |  |  |  |  |  |  |  |  |  |  | WRPJ_Ver4.0-rescue | LT6106-RESCUE-WRPJ_Ver4.0 | U | Reference
D |  |  |  |  |  |  |  |  |  |  |  |  |  |  |  |  |  |  |  |  |  |  | WRPJ_Ver4.0-rescue | LT6106-RESCUE-WRPJ_Ver4.0 | LT6106-RESCUE-WRPJ_Ver4.0 | Value
D |  |  |  |  |  |  |  |  |  |  |  |  |  |  |  |  |  |  |  |  |  |  | WRPJ_Ver4.0-rescue | LT6106-RESCUE-WRPJ_Ver4.0 |  |  | 1 | OUT | openEm
D |  |  |  |  |  |  |  |  |  |  |  |  |  |  |  |  |  |  |  |  |  |  | WRPJ_Ver4.0-rescue | LT6106-RESCUE-WRPJ_Ver4.0 |  |  | 2 | V- | power_in
D |  |  |  |  |  |  |  |  |  |  |  |  |  |  |  |  |  |  |  |  |  |  | WRPJ_Ver4.0-rescue | LT6106-RESCUE-WRPJ_Ver4.0 |  |  | 3 | -IN | input
D |  |  |  |  |  |  |  |  |  |  |  |  |  |  |  |  |  |  |  |  |  |  | WRPJ_Ver4.0-rescue | LT6106-RESCUE-WRPJ_Ver4.0 |  |  | 4 | +IN | input
D |  |  |  |  |  |  |  |  |  |  |  |  |  |  |  |  |  |  |  |  |  |  | WRPJ_Ver4.0-rescue | LT6106-RESCUE-WRPJ_Ver4.0 |  |  | 5 | V+ | power_in
D |  |  |  |  |  |  |  |  |  |  |  |  |  |  |  |  |  |  |  |  |  |  | WRPJ_Ver4.0-cache | Led_Small | D | Reference
D |  |  |  |  |  |  |  |  |  |  |  |  |  |  |  |  |  |  |  |  |  |  | WRPJ_Ver4.0-cache | Led_Small | Led_Small | Value
D |  |  |  |  |  |  |  |  |  |  |  |  |  |  |  |  |  |  |  |  |  |  | WRPJ_Ver4.0-cache | Led_Small |  |  | 1 | K | passive
D |  |  |  |  |  |  |  |  |  |  |  |  |  |  |  |  |  |  |  |  |  |  | WRPJ_Ver4.0-cache | Led_Small |  |  | 2 | A | passive
D |  |  |  |  |  |  |  |  |  |  |  |  |  |  |  |  |  |  |  |  |  |  | WRPJ_Ver4.0-cache | Led_Small |  |  |  |  |  |  |  |  | CP*
D |  |  |  |  |  |  |  |  |  |  |  |  |  |  |  |  |  |  |  |  |  |  | WRPJ_Ver4.0-cache | Led_Small |  |  |  |  |  |  |  |  | SM*
D |  |  |  |  |  |  |  |  |  |  |  |  |  |  |  |  |  |  |  |  |  |  | user_library | MPU-9250 | U | Reference
D |  |  |  |  |  |  |  |  |  |  |  |  |  |  |  |  |  |  |  |  |  |  | user_library | MPU-9250 | MPU-9250 | Value
D |  |  |  |  |  |  |  |  |  |  |  |  |  |  |  |  |  |  |  |  |  |  | user_library | MPU-9250 |  |  | 1 | RESV | passive
D |  |  |  |  |  |  |  |  |  |  |  |  |  |  |  |  |  |  |  |  |  |  | user_library | MPU-9250 |  |  | 7 | AUX_CL | passive
D |  |  |  |  |  |  |  |  |  |  |  |  |  |  |  |  |  |  |  |  |  |  | user_library | MPU-9250 |  |  | 8 | VDDIO | power_in
D |  |  |  |  |  |  |  |  |  |  |  |  |  |  |  |  |  |  |  |  |  |  | user_library | MPU-9250 |  |  | 9 | AD0/SDO | passive
D |  |  |  |  |  |  |  |  |  |  |  |  |  |  |  |  |  |  |  |  |  |  | user_library | MPU-9250 |  |  | 10 | REGOUT | passive
D |  |  |  |  |  |  |  |  |  |  |  |  |  |  |  |  |  |  |  |  |  |  | user_library | MPU-9250 |  |  | 11 | FSYNC | passive
D |  |  |  |  |  |  |  |  |  |  |  |  |  |  |  |  |  |  |  |  |  |  | user_library | MPU-9250 |  |  | 12 | INT | passive
D |  |  |  |  |  |  |  |  |  |  |  |  |  |  |  |  |  |  |  |  |  |  | user_library | MPU-9250 |  |  | 13 | VDD | power_in
D |  |  |  |  |  |  |  |  |  |  |  |  |  |  |  |  |  |  |  |  |  |  | user_library | MPU-9250 |  |  | 18 | GND | power_out
D |  |  |  |  |  |  |  |  |  |  |  |  |  |  |  |  |  |  |  |  |  |  | user_library | MPU-9250 |  |  | 19 | RESV | NotConnected
D |  |  |  |  |  |  |  |  |  |  |  |  |  |  |  |  |  |  |  |  |  |  | user_library | MPU-9250 |  |  | 20 | RESV | passive
D |  |  |  |  |  |  |  |  |  |  |  |  |  |  |  |  |  |  |  |  |  |  | user_library | MPU-9250 |  |  | 21 | AUX_DA | passive
D |  |  |  |  |  |  |  |  |  |  |  |  |  |  |  |  |  |  |  |  |  |  | user_library | MPU-9250 |  |  | 22 | nCS | passive
D |  |  |  |  |  |  |  |  |  |  |  |  |  |  |  |  |  |  |  |  |  |  | user_library | MPU-9250 |  |  | 23 | SCL/SCLK | passive
D |  |  |  |  |  |  |  |  |  |  |  |  |  |  |  |  |  |  |  |  |  |  | user_library | MPU-9250 |  |  | 24 | SDA/SDI | passive
D |  |  |  |  |  |  |  |  |  |  |  |  |  |  |  |  |  |  |  |  |  |  | linear | OP275 | U | Reference |  |  |  |  | Dual Op amp (low power) | analog-dev/op275.pdf
D |  |  |  |  |  |  |  |  |  |  |  |  |  |  |  |  |  |  |  |  |  |  | linear | OP275 | OP275 | Value |  |  |  |  | Dual Op amp (low power) | analog-dev/op275.pdf
D |  |  |  |  |  |  |  |  |  |  |  |  |  |  |  |  |  |  |  |  |  |  | linear | OP275 |  |  | 1 | ~ | output |  | Dual Op amp (low power) | analog-dev/op275.pdf
D |  |  |  |  |  |  |  |  |  |  |  |  |  |  |  |  |  |  |  |  |  |  | linear | OP275 |  |  | 2 | - | input |  | Dual Op amp (low power) | analog-dev/op275.pdf
D |  |  |  |  |  |  |  |  |  |  |  |  |  |  |  |  |  |  |  |  |  |  | linear | OP275 |  |  | 3 | + | input |  | Dual Op amp (low power) | analog-dev/op275.pdf
D |  |  |  |  |  |  |  |  |  |  |  |  |  |  |  |  |  |  |  |  |  |  | linear | OP275 |  |  | 4 | V- | power_in |  | Dual Op amp (low power) | analog-dev/op275.pdf
D |  |  |  |  |  |  |  |  |  |  |  |  |  |  |  |  |  |  |  |  |  |  | linear | OP275 |  |  | 5 | + | input |  | Dual Op amp (low power) | analog-dev/op275.pdf
D |  |  |  |  |  |  |  |  |  |  |  |  |  |  |  |  |  |  |  |  |  |  | linear | OP275 |  |  | 6 | - | input |  | Dual Op amp (low power) | analog-dev/op275.pdf
D |  |  |  |  |  |  |  |  |  |  |  |  |  |  |  |  |  |  |  |  |  |  | linear | OP275 |  |  | 7 | ~ | output |  | Dual Op amp (low power) | analog-dev/op275.pdf
D |  |  |  |  |  |  |  |  |  |  |  |  |  |  |  |  |  |  |  |  |  |  | linear | OP275 |  |  | 8 | V+ | power_in |  | Dual Op amp (low power) | analog-dev/op275.pdf
D |  |  |  |  |  |  |  |  |  |  |  |  |  |  |  |  |  |  |  |  |  |  | linear | OP275 |  |  |  |  |  | ADA4075 | Dual Op amp (low power) | analog-dev/op275.pdf
D |  |  |  |  |  |  |  |  |  |  |  |  |  |  |  |  |  |  |  |  |  |  | linear | OP275 |  |  |  |  |  | MCP6002 | Dual Op amp (low power) | analog-dev/op275.pdf
D |  |  |  |  |  |  |  |  |  |  |  |  |  |  |  |  |  |  |  |  |  |  | linear | OP275 |  |  |  |  |  | LM7332 | Dual Op amp (low power) | analog-dev/op275.pdf
D |  |  |  |  |  |  |  |  |  |  |  |  |  |  |  |  |  |  |  |  |  |  | linear | OP275 |  |  |  |  |  |  | Dual Op amp (low power) | analog-dev/op275.pdf | DIP*W7.62mm*
D |  |  |  |  |  |  |  |  |  |  |  |  |  |  |  |  |  |  |  |  |  |  | linear | OP275 |  |  |  |  |  |  | Dual Op amp (low power) | analog-dev/op275.pdf | SOIC*3.9x4.9mm*Pitch1.27mm*
D |  |  |  |  |  |  |  |  |  |  |  |  |  |  |  |  |  |  |  |  |  |  | linear | OP275 |  |  |  |  |  |  | Dual Op amp (low power) | analog-dev/op275.pdf | SOP*
D |  |  |  |  |  |  |  |  |  |  |  |  |  |  |  |  |  |  |  |  |  |  | linear | OP275 |  |  |  |  |  |  | Dual Op amp (low power) | analog-dev/op275.pdf | LFCSP*
D |  |  |  |  |  |  |  |  |  |  |  |  |  |  |  |  |  |  |  |  |  |  | device | R | R | Reference |  |  |  |  | Resistor
D |  |  |  |  |  |  |  |  |  |  |  |  |  |  |  |  |  |  |  |  |  |  | device | R | R | Value |  |  |  |  | Resistor
D |  |  |  |  |  |  |  |  |  |  |  |  |  |  |  |  |  |  |  |  |  |  | device | R |  |  | 1 | ~ | passive |  | Resistor
D |  |  |  |  |  |  |  |  |  |  |  |  |  |  |  |  |  |  |  |  |  |  | device | R |  |  | 2 | ~ | passive |  | Resistor
D |  |  |  |  |  |  |  |  |  |  |  |  |  |  |  |  |  |  |  |  |  |  | device | R |  |  |  |  |  |  | Resistor |  | R_*
D |  |  |  |  |  |  |  |  |  |  |  |  |  |  |  |  |  |  |  |  |  |  | device | R |  |  |  |  |  |  | Resistor |  | R_*
D |  |  |  |  |  |  |  |  |  |  |  |  |  |  |  |  |  |  |  |  |  |  | device | R_Small | R | Reference |  |  |  |  | Resistor, small symbol
D |  |  |  |  |  |  |  |  |  |  |  |  |  |  |  |  |  |  |  |  |  |  | device | R_Small | R_Small | Value |  |  |  |  | Resistor, small symbol
D |  |  |  |  |  |  |  |  |  |  |  |  |  |  |  |  |  |  |  |  |  |  | device | R_Small |  |  | 1 | ~ | passive |  | Resistor, small symbol
D |  |  |  |  |  |  |  |  |  |  |  |  |  |  |  |  |  |  |  |  |  |  | device | R_Small |  |  | 2 | ~ | passive |  | Resistor, small symbol
D |  |  |  |  |  |  |  |  |  |  |  |  |  |  |  |  |  |  |  |  |  |  | device | R_Small |  |  |  |  |  |  | Resistor, small symbol |  | R_*
D |  |  |  |  |  |  |  |  |  |  |  |  |  |  |  |  |  |  |  |  |  |  | STM32 | STM32F401RBTx | U | Reference |  |  |  |  | Core: ARM Cortex-M4 Package: LQFP64 Flash: 128KB Ram: 64KB Frequency: 84MHz Voltage: 1.7..3.6V IO-pins: 50 | http://www.st.com/st-web-ui/static/active/en/resource/technical/document/datasheet/DM00086815.pdf
D |  |  |  |  |  |  |  |  |  |  |  |  |  |  |  |  |  |  |  |  |  |  | STM32 | STM32F401RBTx | STM32F401RBTx | Value |  |  |  |  | Core: ARM Cortex-M4 Package: LQFP64 Flash: 128KB Ram: 64KB Frequency: 84MHz Voltage: 1.7..3.6V IO-pins: 50 | http://www.st.com/st-web-ui/static/active/en/resource/technical/document/datasheet/DM00086815.pdf
D |  |  |  |  |  |  |  |  |  |  |  |  |  |  |  |  |  |  |  |  |  |  | STM32 | STM32F401RBTx | LQFP64 | Footprint |  |  |  |  | Core: ARM Cortex-M4 Package: LQFP64 Flash: 128KB Ram: 64KB Frequency: 84MHz Voltage: 1.7..3.6V IO-pins: 50 | http://www.st.com/st-web-ui/static/active/en/resource/technical/document/datasheet/DM00086815.pdf
D |  |  |  |  |  |  |  |  |  |  |  |  |  |  |  |  |  |  |  |  |  |  | STM32 | STM32F401RBTx |  |  | 1 | VBAT | power_in |  | Core: ARM Cortex-M4 Package: LQFP64 Flash: 128KB Ram: 64KB Frequency: 84MHz Voltage: 1.7..3.6V IO-pins: 50 | http://www.st.com/st-web-ui/static/active/en/resource/technical/document/datasheet/DM00086815.pdf
D |  |  |  |  |  |  |  |  |  |  |  |  |  |  |  |  |  |  |  |  |  |  | STM32 | STM32F401RBTx |  |  | 2 | PC13/ANTI_TAMP/RTC_AF1 | BiDi |  | Core: ARM Cortex-M4 Package: LQFP64 Flash: 128KB Ram: 64KB Frequency: 84MHz Voltage: 1.7..3.6V IO-pins: 50 | http://www.st.com/st-web-ui/static/active/en/resource/technical/document/datasheet/DM00086815.pdf
D |  |  |  |  |  |  |  |  |  |  |  |  |  |  |  |  |  |  |  |  |  |  | STM32 | STM32F401RBTx |  |  | 3 | PC14/RCC_OSC32_IN | BiDi |  | Core: ARM Cortex-M4 Package: LQFP64 Flash: 128KB Ram: 64KB Frequency: 84MHz Voltage: 1.7..3.6V IO-pins: 50 | http://www.st.com/st-web-ui/static/active/en/resource/technical/document/datasheet/DM00086815.pdf
D |  |  |  |  |  |  |  |  |  |  |  |  |  |  |  |  |  |  |  |  |  |  | STM32 | STM32F401RBTx |  |  | 4 | PC15/ADC1_EXTI15/RCC_OSC32_OUT | BiDi |  | Core: ARM Cortex-M4 Package: LQFP64 Flash: 128KB Ram: 64KB Frequency: 84MHz Voltage: 1.7..3.6V IO-pins: 50 | http://www.st.com/st-web-ui/static/active/en/resource/technical/document/datasheet/DM00086815.pdf
D |  |  |  |  |  |  |  |  |  |  |  |  |  |  |  |  |  |  |  |  |  |  | STM32 | STM32F401RBTx |  |  | 5 | PH0/RCC_OSC_IN | input |  | Core: ARM Cortex-M4 Package: LQFP64 Flash: 128KB Ram: 64KB Frequency: 84MHz Voltage: 1.7..3.6V IO-pins: 50 | http://www.st.com/st-web-ui/static/active/en/resource/technical/document/datasheet/DM00086815.pdf
D |  |  |  |  |  |  |  |  |  |  |  |  |  |  |  |  |  |  |  |  |  |  | STM32 | STM32F401RBTx |  |  | 6 | PH1/RCC_OSC_OUT | input |  | Core: ARM Cortex-M4 Package: LQFP64 Flash: 128KB Ram: 64KB Frequency: 84MHz Voltage: 1.7..3.6V IO-pins: 50 | http://www.st.com/st-web-ui/static/active/en/resource/technical/document/datasheet/DM00086815.pdf
D |  |  |  |  |  |  |  |  |  |  |  |  |  |  |  |  |  |  |  |  |  |  | STM32 | STM32F401RBTx |  |  | 7 | NRST | input |  | Core: ARM Cortex-M4 Package: LQFP64 Flash: 128KB Ram: 64KB Frequency: 84MHz Voltage: 1.7..3.6V IO-pins: 50 | http://www.st.com/st-web-ui/static/active/en/resource/technical/document/datasheet/DM00086815.pdf
D |  |  |  |  |  |  |  |  |  |  |  |  |  |  |  |  |  |  |  |  |  |  | STM32 | STM32F401RBTx |  |  | 8 | PC0/ADC1_IN10 | BiDi |  | Core: ARM Cortex-M4 Package: LQFP64 Flash: 128KB Ram: 64KB Frequency: 84MHz Voltage: 1.7..3.6V IO-pins: 50 | http://www.st.com/st-web-ui/static/active/en/resource/technical/document/datasheet/DM00086815.pdf
D |  |  |  |  |  |  |  |  |  |  |  |  |  |  |  |  |  |  |  |  |  |  | STM32 | STM32F401RBTx |  |  | 9 | PC1/ADC1_IN11 | BiDi |  | Core: ARM Cortex-M4 Package: LQFP64 Flash: 128KB Ram: 64KB Frequency: 84MHz Voltage: 1.7..3.6V IO-pins: 50 | http://www.st.com/st-web-ui/static/active/en/resource/technical/document/datasheet/DM00086815.pdf
D |  |  |  |  |  |  |  |  |  |  |  |  |  |  |  |  |  |  |  |  |  |  | STM32 | STM32F401RBTx |  |  | 10 | PC2/ADC1_IN12/I2S2_ext_SD/SPI2_MISO | BiDi |  | Core: ARM Cortex-M4 Package: LQFP64 Flash: 128KB Ram: 64KB Frequency: 84MHz Voltage: 1.7..3.6V IO-pins: 50 | http://www.st.com/st-web-ui/static/active/en/resource/technical/document/datasheet/DM00086815.pdf
D |  |  |  |  |  |  |  |  |  |  |  |  |  |  |  |  |  |  |  |  |  |  | STM32 | STM32F401RBTx |  |  | 11 | PC3/ADC1_IN13/I2S2_SD/SPI2_MOSI | BiDi |  | Core: ARM Cortex-M4 Package: LQFP64 Flash: 128KB Ram: 64KB Frequency: 84MHz Voltage: 1.7..3.6V IO-pins: 50 | http://www.st.com/st-web-ui/static/active/en/resource/technical/document/datasheet/DM00086815.pdf
D |  |  |  |  |  |  |  |  |  |  |  |  |  |  |  |  |  |  |  |  |  |  | STM32 | STM32F401RBTx |  |  | 12 | VSSA | power_in |  | Core: ARM Cortex-M4 Package: LQFP64 Flash: 128KB Ram: 64KB Frequency: 84MHz Voltage: 1.7..3.6V IO-pins: 50 | http://www.st.com/st-web-ui/static/active/en/resource/technical/document/datasheet/DM00086815.pdf
D |  |  |  |  |  |  |  |  |  |  |  |  |  |  |  |  |  |  |  |  |  |  | STM32 | STM32F401RBTx |  |  | 13 | VREF+ | power_in |  | Core: ARM Cortex-M4 Package: LQFP64 Flash: 128KB Ram: 64KB Frequency: 84MHz Voltage: 1.7..3.6V IO-pins: 50 | http://www.st.com/st-web-ui/static/active/en/resource/technical/document/datasheet/DM00086815.pdf
D |  |  |  |  |  |  |  |  |  |  |  |  |  |  |  |  |  |  |  |  |  |  | STM32 | STM32F401RBTx |  |  | 14 | ADC1_IN0/SYS_WKUP/TIM2_CH1/TIM2_ETR/TIM5_CH1/USART2_CTS/PA0 | BiDi |  | Core: ARM Cortex-M4 Package: LQFP64 Flash: 128KB Ram: 64KB Frequency: 84MHz Voltage: 1.7..3.6V IO-pins: 50 | http://www.st.com/st-web-ui/static/active/en/resource/technical/document/datasheet/DM00086815.pdf
D |  |  |  |  |  |  |  |  |  |  |  |  |  |  |  |  |  |  |  |  |  |  | STM32 | STM32F401RBTx |  |  | 15 | ADC1_IN1/TIM2_CH2/TIM5_CH2/USART2_RTS/PA1 | BiDi |  | Core: ARM Cortex-M4 Package: LQFP64 Flash: 128KB Ram: 64KB Frequency: 84MHz Voltage: 1.7..3.6V IO-pins: 50 | http://www.st.com/st-web-ui/static/active/en/resource/technical/document/datasheet/DM00086815.pdf
D |  |  |  |  |  |  |  |  |  |  |  |  |  |  |  |  |  |  |  |  |  |  | STM32 | STM32F401RBTx |  |  | 16 | ADC1_IN2/TIM2_CH3/TIM5_CH3/TIM9_CH1/USART2_TX/PA2 | BiDi |  | Core: ARM Cortex-M4 Package: LQFP64 Flash: 128KB Ram: 64KB Frequency: 84MHz Voltage: 1.7..3.6V IO-pins: 50 | http://www.st.com/st-web-ui/static/active/en/resource/technical/document/datasheet/DM00086815.pdf
D |  |  |  |  |  |  |  |  |  |  |  |  |  |  |  |  |  |  |  |  |  |  | STM32 | STM32F401RBTx |  |  | 17 | ADC1_IN3/TIM2_CH4/TIM5_CH4/TIM9_CH2/USART2_RX/PA3 | BiDi |  | Core: ARM Cortex-M4 Package: LQFP64 Flash: 128KB Ram: 64KB Frequency: 84MHz Voltage: 1.7..3.6V IO-pins: 50 | http://www.st.com/st-web-ui/static/active/en/resource/technical/document/datasheet/DM00086815.pdf
D |  |  |  |  |  |  |  |  |  |  |  |  |  |  |  |  |  |  |  |  |  |  | STM32 | STM32F401RBTx |  |  | 18 | VSS | power_in |  | Core: ARM Cortex-M4 Package: LQFP64 Flash: 128KB Ram: 64KB Frequency: 84MHz Voltage: 1.7..3.6V IO-pins: 50 | http://www.st.com/st-web-ui/static/active/en/resource/technical/document/datasheet/DM00086815.pdf
D |  |  |  |  |  |  |  |  |  |  |  |  |  |  |  |  |  |  |  |  |  |  | STM32 | STM32F401RBTx |  |  | 19 | VDD | power_in |  | Core: ARM Cortex-M4 Package: LQFP64 Flash: 128KB Ram: 64KB Frequency: 84MHz Voltage: 1.7..3.6V IO-pins: 50 | http://www.st.com/st-web-ui/static/active/en/resource/technical/document/datasheet/DM00086815.pdf
D |  |  |  |  |  |  |  |  |  |  |  |  |  |  |  |  |  |  |  |  |  |  | STM32 | STM32F401RBTx |  |  | 20 | ADC1_IN4/I2S3_WS/SPI1_NSS/SPI3_NSS/USART2_CK/PA4 | BiDi |  | Core: ARM Cortex-M4 Package: LQFP64 Flash: 128KB Ram: 64KB Frequency: 84MHz Voltage: 1.7..3.6V IO-pins: 50 | http://www.st.com/st-web-ui/static/active/en/resource/technical/document/datasheet/DM00086815.pdf
D |  |  |  |  |  |  |  |  |  |  |  |  |  |  |  |  |  |  |  |  |  |  | STM32 | STM32F401RBTx |  |  | 21 | ADC1_IN5/SPI1_SCK/TIM2_CH1/TIM2_ETR/PA5 | BiDi |  | Core: ARM Cortex-M4 Package: LQFP64 Flash: 128KB Ram: 64KB Frequency: 84MHz Voltage: 1.7..3.6V IO-pins: 50 | http://www.st.com/st-web-ui/static/active/en/resource/technical/document/datasheet/DM00086815.pdf
D |  |  |  |  |  |  |  |  |  |  |  |  |  |  |  |  |  |  |  |  |  |  | STM32 | STM32F401RBTx |  |  | 22 | ADC1_IN6/SPI1_MISO/TIM1_BKIN/TIM3_CH1/PA6 | BiDi |  | Core: ARM Cortex-M4 Package: LQFP64 Flash: 128KB Ram: 64KB Frequency: 84MHz Voltage: 1.7..3.6V IO-pins: 50 | http://www.st.com/st-web-ui/static/active/en/resource/technical/document/datasheet/DM00086815.pdf
D |  |  |  |  |  |  |  |  |  |  |  |  |  |  |  |  |  |  |  |  |  |  | STM32 | STM32F401RBTx |  |  | 23 | ADC1_IN7/SPI1_MOSI/TIM1_CH1N/TIM3_CH2/PA7 | BiDi |  | Core: ARM Cortex-M4 Package: LQFP64 Flash: 128KB Ram: 64KB Frequency: 84MHz Voltage: 1.7..3.6V IO-pins: 50 | http://www.st.com/st-web-ui/static/active/en/resource/technical/document/datasheet/DM00086815.pdf
D |  |  |  |  |  |  |  |  |  |  |  |  |  |  |  |  |  |  |  |  |  |  | STM32 | STM32F401RBTx |  |  | 24 | PC4/ADC1_IN14 | BiDi |  | Core: ARM Cortex-M4 Package: LQFP64 Flash: 128KB Ram: 64KB Frequency: 84MHz Voltage: 1.7..3.6V IO-pins: 50 | http://www.st.com/st-web-ui/static/active/en/resource/technical/document/datasheet/DM00086815.pdf
D |  |  |  |  |  |  |  |  |  |  |  |  |  |  |  |  |  |  |  |  |  |  | STM32 | STM32F401RBTx |  |  | 25 | PC5/ADC1_IN15 | BiDi |  | Core: ARM Cortex-M4 Package: LQFP64 Flash: 128KB Ram: 64KB Frequency: 84MHz Voltage: 1.7..3.6V IO-pins: 50 | http://www.st.com/st-web-ui/static/active/en/resource/technical/document/datasheet/DM00086815.pdf
D |  |  |  |  |  |  |  |  |  |  |  |  |  |  |  |  |  |  |  |  |  |  | STM32 | STM32F401RBTx |  |  | 26 | ADC1_IN8/TIM1_CH2N/TIM3_CH3/PB0 | BiDi |  | Core: ARM Cortex-M4 Package: LQFP64 Flash: 128KB Ram: 64KB Frequency: 84MHz Voltage: 1.7..3.6V IO-pins: 50 | http://www.st.com/st-web-ui/static/active/en/resource/technical/document/datasheet/DM00086815.pdf
D |  |  |  |  |  |  |  |  |  |  |  |  |  |  |  |  |  |  |  |  |  |  | STM32 | STM32F401RBTx |  |  | 27 | ADC1_IN9/TIM1_CH3N/TIM3_CH4/PB1 | BiDi |  | Core: ARM Cortex-M4 Package: LQFP64 Flash: 128KB Ram: 64KB Frequency: 84MHz Voltage: 1.7..3.6V IO-pins: 50 | http://www.st.com/st-web-ui/static/active/en/resource/technical/document/datasheet/DM00086815.pdf
D |  |  |  |  |  |  |  |  |  |  |  |  |  |  |  |  |  |  |  |  |  |  | STM32 | STM32F401RBTx |  |  | 28 | BOOT1/PB2 | BiDi |  | Core: ARM Cortex-M4 Package: LQFP64 Flash: 128KB Ram: 64KB Frequency: 84MHz Voltage: 1.7..3.6V IO-pins: 50 | http://www.st.com/st-web-ui/static/active/en/resource/technical/document/datasheet/DM00086815.pdf
D |  |  |  |  |  |  |  |  |  |  |  |  |  |  |  |  |  |  |  |  |  |  | STM32 | STM32F401RBTx |  |  | 29 | I2C2_SCL/I2S2_CK/SPI2_SCK/TIM2_CH3/PB10 | BiDi |  | Core: ARM Cortex-M4 Package: LQFP64 Flash: 128KB Ram: 64KB Frequency: 84MHz Voltage: 1.7..3.6V IO-pins: 50 | http://www.st.com/st-web-ui/static/active/en/resource/technical/document/datasheet/DM00086815.pdf
D |  |  |  |  |  |  |  |  |  |  |  |  |  |  |  |  |  |  |  |  |  |  | STM32 | STM32F401RBTx |  |  | 30 | VCAP1 | power_in |  | Core: ARM Cortex-M4 Package: LQFP64 Flash: 128KB Ram: 64KB Frequency: 84MHz Voltage: 1.7..3.6V IO-pins: 50 | http://www.st.com/st-web-ui/static/active/en/resource/technical/document/datasheet/DM00086815.pdf
D |  |  |  |  |  |  |  |  |  |  |  |  |  |  |  |  |  |  |  |  |  |  | STM32 | STM32F401RBTx |  |  | 31 | VSS | power_in |  | Core: ARM Cortex-M4 Package: LQFP64 Flash: 128KB Ram: 64KB Frequency: 84MHz Voltage: 1.7..3.6V IO-pins: 50 | http://www.st.com/st-web-ui/static/active/en/resource/technical/document/datasheet/DM00086815.pdf
D |  |  |  |  |  |  |  |  |  |  |  |  |  |  |  |  |  |  |  |  |  |  | STM32 | STM32F401RBTx |  |  | 32 | VDD | power_in |  | Core: ARM Cortex-M4 Package: LQFP64 Flash: 128KB Ram: 64KB Frequency: 84MHz Voltage: 1.7..3.6V IO-pins: 50 | http://www.st.com/st-web-ui/static/active/en/resource/technical/document/datasheet/DM00086815.pdf
D |  |  |  |  |  |  |  |  |  |  |  |  |  |  |  |  |  |  |  |  |  |  | STM32 | STM32F401RBTx |  |  | 33 | I2C2_SMBA/I2S2_WS/SPI2_NSS/TIM1_BKIN/PB12 | BiDi |  | Core: ARM Cortex-M4 Package: LQFP64 Flash: 128KB Ram: 64KB Frequency: 84MHz Voltage: 1.7..3.6V IO-pins: 50 | http://www.st.com/st-web-ui/static/active/en/resource/technical/document/datasheet/DM00086815.pdf
D |  |  |  |  |  |  |  |  |  |  |  |  |  |  |  |  |  |  |  |  |  |  | STM32 | STM32F401RBTx |  |  | 34 | I2S2_CK/SPI2_SCK/TIM1_CH1N/PB13 | BiDi |  | Core: ARM Cortex-M4 Package: LQFP64 Flash: 128KB Ram: 64KB Frequency: 84MHz Voltage: 1.7..3.6V IO-pins: 50 | http://www.st.com/st-web-ui/static/active/en/resource/technical/document/datasheet/DM00086815.pdf
D |  |  |  |  |  |  |  |  |  |  |  |  |  |  |  |  |  |  |  |  |  |  | STM32 | STM32F401RBTx |  |  | 35 | I2S2_ext_SD/SPI2_MISO/TIM1_CH2N/PB14 | BiDi |  | Core: ARM Cortex-M4 Package: LQFP64 Flash: 128KB Ram: 64KB Frequency: 84MHz Voltage: 1.7..3.6V IO-pins: 50 | http://www.st.com/st-web-ui/static/active/en/resource/technical/document/datasheet/DM00086815.pdf
D |  |  |  |  |  |  |  |  |  |  |  |  |  |  |  |  |  |  |  |  |  |  | STM32 | STM32F401RBTx |  |  | 36 | ADC1_EXTI15/I2S2_SD/RTC_REFIN/SPI2_MOSI/TIM1_CH3N/PB15 | BiDi |  | Core: ARM Cortex-M4 Package: LQFP64 Flash: 128KB Ram: 64KB Frequency: 84MHz Voltage: 1.7..3.6V IO-pins: 50 | http://www.st.com/st-web-ui/static/active/en/resource/technical/document/datasheet/DM00086815.pdf
D |  |  |  |  |  |  |  |  |  |  |  |  |  |  |  |  |  |  |  |  |  |  | STM32 | STM32F401RBTx |  |  | 37 | PC6/I2S2_MCK/SDIO_D6/TIM3_CH1/USART6_TX | BiDi |  | Core: ARM Cortex-M4 Package: LQFP64 Flash: 128KB Ram: 64KB Frequency: 84MHz Voltage: 1.7..3.6V IO-pins: 50 | http://www.st.com/st-web-ui/static/active/en/resource/technical/document/datasheet/DM00086815.pdf
D |  |  |  |  |  |  |  |  |  |  |  |  |  |  |  |  |  |  |  |  |  |  | STM32 | STM32F401RBTx |  |  | 38 | PC7/I2S3_MCK/SDIO_D7/TIM3_CH2/USART6_RX | BiDi |  | Core: ARM Cortex-M4 Package: LQFP64 Flash: 128KB Ram: 64KB Frequency: 84MHz Voltage: 1.7..3.6V IO-pins: 50 | http://www.st.com/st-web-ui/static/active/en/resource/technical/document/datasheet/DM00086815.pdf
D |  |  |  |  |  |  |  |  |  |  |  |  |  |  |  |  |  |  |  |  |  |  | STM32 | STM32F401RBTx |  |  | 39 | PC8/SDIO_D0/TIM3_CH3/USART6_CK | BiDi |  | Core: ARM Cortex-M4 Package: LQFP64 Flash: 128KB Ram: 64KB Frequency: 84MHz Voltage: 1.7..3.6V IO-pins: 50 | http://www.st.com/st-web-ui/static/active/en/resource/technical/document/datasheet/DM00086815.pdf
D |  |  |  |  |  |  |  |  |  |  |  |  |  |  |  |  |  |  |  |  |  |  | STM32 | STM32F401RBTx |  |  | 40 | PC9/I2C3_SDA/I2S_CKIN/RCC_MCO_2/SDIO_D1/TIM3_CH4 | BiDi |  | Core: ARM Cortex-M4 Package: LQFP64 Flash: 128KB Ram: 64KB Frequency: 84MHz Voltage: 1.7..3.6V IO-pins: 50 | http://www.st.com/st-web-ui/static/active/en/resource/technical/document/datasheet/DM00086815.pdf
D |  |  |  |  |  |  |  |  |  |  |  |  |  |  |  |  |  |  |  |  |  |  | STM32 | STM32F401RBTx |  |  | 41 | I2C3_SCL/RCC_MCO_1/TIM1_CH1/USART1_CK/USB_OTG_FS_SOF/PA8 | BiDi |  | Core: ARM Cortex-M4 Package: LQFP64 Flash: 128KB Ram: 64KB Frequency: 84MHz Voltage: 1.7..3.6V IO-pins: 50 | http://www.st.com/st-web-ui/static/active/en/resource/technical/document/datasheet/DM00086815.pdf
D |  |  |  |  |  |  |  |  |  |  |  |  |  |  |  |  |  |  |  |  |  |  | STM32 | STM32F401RBTx |  |  | 42 | I2C3_SMBA/TIM1_CH2/USART1_TX/USB_OTG_FS_VBUS/PA9 | BiDi |  | Core: ARM Cortex-M4 Package: LQFP64 Flash: 128KB Ram: 64KB Frequency: 84MHz Voltage: 1.7..3.6V IO-pins: 50 | http://www.st.com/st-web-ui/static/active/en/resource/technical/document/datasheet/DM00086815.pdf
D |  |  |  |  |  |  |  |  |  |  |  |  |  |  |  |  |  |  |  |  |  |  | STM32 | STM32F401RBTx |  |  | 43 | TIM1_CH3/USART1_RX/USB_OTG_FS_ID/PA10 | BiDi |  | Core: ARM Cortex-M4 Package: LQFP64 Flash: 128KB Ram: 64KB Frequency: 84MHz Voltage: 1.7..3.6V IO-pins: 50 | http://www.st.com/st-web-ui/static/active/en/resource/technical/document/datasheet/DM00086815.pdf
D |  |  |  |  |  |  |  |  |  |  |  |  |  |  |  |  |  |  |  |  |  |  | STM32 | STM32F401RBTx |  |  | 44 | ADC1_EXTI11/TIM1_CH4/USART1_CTS/USART6_TX/USB_OTG_FS_DM/PA11 | BiDi |  | Core: ARM Cortex-M4 Package: LQFP64 Flash: 128KB Ram: 64KB Frequency: 84MHz Voltage: 1.7..3.6V IO-pins: 50 | http://www.st.com/st-web-ui/static/active/en/resource/technical/document/datasheet/DM00086815.pdf
D |  |  |  |  |  |  |  |  |  |  |  |  |  |  |  |  |  |  |  |  |  |  | STM32 | STM32F401RBTx |  |  | 45 | TIM1_ETR/USART1_RTS/USART6_RX/USB_OTG_FS_DP/PA12 | BiDi |  | Core: ARM Cortex-M4 Package: LQFP64 Flash: 128KB Ram: 64KB Frequency: 84MHz Voltage: 1.7..3.6V IO-pins: 50 | http://www.st.com/st-web-ui/static/active/en/resource/technical/document/datasheet/DM00086815.pdf
D |  |  |  |  |  |  |  |  |  |  |  |  |  |  |  |  |  |  |  |  |  |  | STM32 | STM32F401RBTx |  |  | 46 | SYS_JTMS-SWDIO/PA13 | BiDi |  | Core: ARM Cortex-M4 Package: LQFP64 Flash: 128KB Ram: 64KB Frequency: 84MHz Voltage: 1.7..3.6V IO-pins: 50 | http://www.st.com/st-web-ui/static/active/en/resource/technical/document/datasheet/DM00086815.pdf
D |  |  |  |  |  |  |  |  |  |  |  |  |  |  |  |  |  |  |  |  |  |  | STM32 | STM32F401RBTx |  |  | 47 | VSS | power_in |  | Core: ARM Cortex-M4 Package: LQFP64 Flash: 128KB Ram: 64KB Frequency: 84MHz Voltage: 1.7..3.6V IO-pins: 50 | http://www.st.com/st-web-ui/static/active/en/resource/technical/document/datasheet/DM00086815.pdf
D |  |  |  |  |  |  |  |  |  |  |  |  |  |  |  |  |  |  |  |  |  |  | STM32 | STM32F401RBTx |  |  | 48 | VDD | power_in |  | Core: ARM Cortex-M4 Package: LQFP64 Flash: 128KB Ram: 64KB Frequency: 84MHz Voltage: 1.7..3.6V IO-pins: 50 | http://www.st.com/st-web-ui/static/active/en/resource/technical/document/datasheet/DM00086815.pdf
D |  |  |  |  |  |  |  |  |  |  |  |  |  |  |  |  |  |  |  |  |  |  | STM32 | STM32F401RBTx |  |  | 49 | SYS_JTCK-SWCLK/PA14 | BiDi |  | Core: ARM Cortex-M4 Package: LQFP64 Flash: 128KB Ram: 64KB Frequency: 84MHz Voltage: 1.7..3.6V IO-pins: 50 | http://www.st.com/st-web-ui/static/active/en/resource/technical/document/datasheet/DM00086815.pdf
D |  |  |  |  |  |  |  |  |  |  |  |  |  |  |  |  |  |  |  |  |  |  | STM32 | STM32F401RBTx |  |  | 50 | ADC1_EXTI15/I2S3_WS/SPI1_NSS/SPI3_NSS/SYS_JTDI/TIM2_CH1/TIM2_ETR/PA15 | BiDi |  | Core: ARM Cortex-M4 Package: LQFP64 Flash: 128KB Ram: 64KB Frequency: 84MHz Voltage: 1.7..3.6V IO-pins: 50 | http://www.st.com/st-web-ui/static/active/en/resource/technical/document/datasheet/DM00086815.pdf
D |  |  |  |  |  |  |  |  |  |  |  |  |  |  |  |  |  |  |  |  |  |  | STM32 | STM32F401RBTx |  |  | 51 | PC10/I2S3_CK/SDIO_D2/SPI3_SCK | BiDi |  | Core: ARM Cortex-M4 Package: LQFP64 Flash: 128KB Ram: 64KB Frequency: 84MHz Voltage: 1.7..3.6V IO-pins: 50 | http://www.st.com/st-web-ui/static/active/en/resource/technical/document/datasheet/DM00086815.pdf
D |  |  |  |  |  |  |  |  |  |  |  |  |  |  |  |  |  |  |  |  |  |  | STM32 | STM32F401RBTx |  |  | 52 | PC11/ADC1_EXTI11/I2S3_ext_SD/SDIO_D3/SPI3_MISO | BiDi |  | Core: ARM Cortex-M4 Package: LQFP64 Flash: 128KB Ram: 64KB Frequency: 84MHz Voltage: 1.7..3.6V IO-pins: 50 | http://www.st.com/st-web-ui/static/active/en/resource/technical/document/datasheet/DM00086815.pdf
D |  |  |  |  |  |  |  |  |  |  |  |  |  |  |  |  |  |  |  |  |  |  | STM32 | STM32F401RBTx |  |  | 53 | PC12/I2S3_SD/SDIO_CK/SPI3_MOSI | BiDi |  | Core: ARM Cortex-M4 Package: LQFP64 Flash: 128KB Ram: 64KB Frequency: 84MHz Voltage: 1.7..3.6V IO-pins: 50 | http://www.st.com/st-web-ui/static/active/en/resource/technical/document/datasheet/DM00086815.pdf
D |  |  |  |  |  |  |  |  |  |  |  |  |  |  |  |  |  |  |  |  |  |  | STM32 | STM32F401RBTx |  |  | 54 | PD2/SDIO_CMD/TIM3_ETR | BiDi |  | Core: ARM Cortex-M4 Package: LQFP64 Flash: 128KB Ram: 64KB Frequency: 84MHz Voltage: 1.7..3.6V IO-pins: 50 | http://www.st.com/st-web-ui/static/active/en/resource/technical/document/datasheet/DM00086815.pdf
D |  |  |  |  |  |  |  |  |  |  |  |  |  |  |  |  |  |  |  |  |  |  | STM32 | STM32F401RBTx |  |  | 55 | I2C2_SDA/I2S3_CK/SPI1_SCK/SPI3_SCK/SYS_JTDO-SWO/TIM2_CH2/PB3 | BiDi |  | Core: ARM Cortex-M4 Package: LQFP64 Flash: 128KB Ram: 64KB Frequency: 84MHz Voltage: 1.7..3.6V IO-pins: 50 | http://www.st.com/st-web-ui/static/active/en/resource/technical/document/datasheet/DM00086815.pdf
D |  |  |  |  |  |  |  |  |  |  |  |  |  |  |  |  |  |  |  |  |  |  | STM32 | STM32F401RBTx |  |  | 56 | I2C3_SDA/I2S3_ext_SD/SPI1_MISO/SPI3_MISO/SYS_JTRST/TIM3_CH1/PB4 | BiDi |  | Core: ARM Cortex-M4 Package: LQFP64 Flash: 128KB Ram: 64KB Frequency: 84MHz Voltage: 1.7..3.6V IO-pins: 50 | http://www.st.com/st-web-ui/static/active/en/resource/technical/document/datasheet/DM00086815.pdf
D |  |  |  |  |  |  |  |  |  |  |  |  |  |  |  |  |  |  |  |  |  |  | STM32 | STM32F401RBTx |  |  | 57 | I2C1_SMBA/I2S3_SD/SPI1_MOSI/SPI3_MOSI/TIM3_CH2/PB5 | BiDi |  | Core: ARM Cortex-M4 Package: LQFP64 Flash: 128KB Ram: 64KB Frequency: 84MHz Voltage: 1.7..3.6V IO-pins: 50 | http://www.st.com/st-web-ui/static/active/en/resource/technical/document/datasheet/DM00086815.pdf
D |  |  |  |  |  |  |  |  |  |  |  |  |  |  |  |  |  |  |  |  |  |  | STM32 | STM32F401RBTx |  |  | 58 | I2C1_SCL/TIM4_CH1/USART1_TX/PB6 | BiDi |  | Core: ARM Cortex-M4 Package: LQFP64 Flash: 128KB Ram: 64KB Frequency: 84MHz Voltage: 1.7..3.6V IO-pins: 50 | http://www.st.com/st-web-ui/static/active/en/resource/technical/document/datasheet/DM00086815.pdf
D |  |  |  |  |  |  |  |  |  |  |  |  |  |  |  |  |  |  |  |  |  |  | STM32 | STM32F401RBTx |  |  | 59 | I2C1_SDA/TIM4_CH2/USART1_RX/PB7 | BiDi |  | Core: ARM Cortex-M4 Package: LQFP64 Flash: 128KB Ram: 64KB Frequency: 84MHz Voltage: 1.7..3.6V IO-pins: 50 | http://www.st.com/st-web-ui/static/active/en/resource/technical/document/datasheet/DM00086815.pdf
D |  |  |  |  |  |  |  |  |  |  |  |  |  |  |  |  |  |  |  |  |  |  | STM32 | STM32F401RBTx |  |  | 60 | BOOT0 | input |  | Core: ARM Cortex-M4 Package: LQFP64 Flash: 128KB Ram: 64KB Frequency: 84MHz Voltage: 1.7..3.6V IO-pins: 50 | http://www.st.com/st-web-ui/static/active/en/resource/technical/document/datasheet/DM00086815.pdf
D |  |  |  |  |  |  |  |  |  |  |  |  |  |  |  |  |  |  |  |  |  |  | STM32 | STM32F401RBTx |  |  | 61 | I2C1_SCL/SDIO_D4/TIM10_CH1/TIM4_CH3/PB8 | BiDi |  | Core: ARM Cortex-M4 Package: LQFP64 Flash: 128KB Ram: 64KB Frequency: 84MHz Voltage: 1.7..3.6V IO-pins: 50 | http://www.st.com/st-web-ui/static/active/en/resource/technical/document/datasheet/DM00086815.pdf
D |  |  |  |  |  |  |  |  |  |  |  |  |  |  |  |  |  |  |  |  |  |  | STM32 | STM32F401RBTx |  |  | 62 | I2C1_SDA/I2S2_WS/SDIO_D5/SPI2_NSS/TIM11_CH1/TIM4_CH4/PB9 | BiDi |  | Core: ARM Cortex-M4 Package: LQFP64 Flash: 128KB Ram: 64KB Frequency: 84MHz Voltage: 1.7..3.6V IO-pins: 50 | http://www.st.com/st-web-ui/static/active/en/resource/technical/document/datasheet/DM00086815.pdf
D |  |  |  |  |  |  |  |  |  |  |  |  |  |  |  |  |  |  |  |  |  |  | STM32 | STM32F401RBTx |  |  | 63 | VSS | power_in |  | Core: ARM Cortex-M4 Package: LQFP64 Flash: 128KB Ram: 64KB Frequency: 84MHz Voltage: 1.7..3.6V IO-pins: 50 | http://www.st.com/st-web-ui/static/active/en/resource/technical/document/datasheet/DM00086815.pdf
D |  |  |  |  |  |  |  |  |  |  |  |  |  |  |  |  |  |  |  |  |  |  | STM32 | STM32F401RBTx |  |  | 64 | VDD | power_in |  | Core: ARM Cortex-M4 Package: LQFP64 Flash: 128KB Ram: 64KB Frequency: 84MHz Voltage: 1.7..3.6V IO-pins: 50 | http://www.st.com/st-web-ui/static/active/en/resource/technical/document/datasheet/DM00086815.pdf
D |  |  |  |  |  |  |  |  |  |  |  |  |  |  |  |  |  |  |  |  |  |  | STM32 | STM32F401RBTx |  |  |  |  |  | STM32F401RCTx | Core: ARM Cortex-M4 Package: LQFP64 Flash: 128KB Ram: 64KB Frequency: 84MHz Voltage: 1.7..3.6V IO-pins: 50 | http://www.st.com/st-web-ui/static/active/en/resource/technical/document/datasheet/DM00086815.pdf
D |  |  |  |  |  |  |  |  |  |  |  |  |  |  |  |  |  |  |  |  |  |  | WRPJ_Ver4.0-cache | SWITCH_INV | SW | Reference
D |  |  |  |  |  |  |  |  |  |  |  |  |  |  |  |  |  |  |  |  |  |  | WRPJ_Ver4.0-cache | SWITCH_INV | SWITCH_INV | Value
D |  |  |  |  |  |  |  |  |  |  |  |  |  |  |  |  |  |  |  |  |  |  | WRPJ_Ver4.0-cache | SWITCH_INV |  |  | 1 | 1 | passive
D |  |  |  |  |  |  |  |  |  |  |  |  |  |  |  |  |  |  |  |  |  |  | WRPJ_Ver4.0-cache | SWITCH_INV |  |  | 2 | 2 | passive
D |  |  |  |  |  |  |  |  |  |  |  |  |  |  |  |  |  |  |  |  |  |  | WRPJ_Ver4.0-cache | SWITCH_INV |  |  | 3 | 3 | passive
D |  |  |  |  |  |  |  |  |  |  |  |  |  |  |  |  |  |  |  |  |  |  | TWE-Lite | TWE_LITE_SMD | U | Reference
D |  |  |  |  |  |  |  |  |  |  |  |  |  |  |  |  |  |  |  |  |  |  | TWE-Lite | TWE_LITE_SMD | TWE_LITE_SMD | Value
D |  |  |  |  |  |  |  |  |  |  |  |  |  |  |  |  |  |  |  |  |  |  | TWE-Lite | TWE_LITE_SMD | MODULE | Footprint
D |  |  |  |  |  |  |  |  |  |  |  |  |  |  |  |  |  |  |  |  |  |  | TWE-Lite | TWE_LITE_SMD | DOCUMENTATION | Datasheet
D |  |  |  |  |  |  |  |  |  |  |  |  |  |  |  |  |  |  |  |  |  |  | TWE-Lite | TWE_LITE_SMD |  |  | 1 | PWM2 | output
D |  |  |  |  |  |  |  |  |  |  |  |  |  |  |  |  |  |  |  |  |  |  | TWE-Lite | TWE_LITE_SMD |  |  | 2 | PWM3(PRG) | BiDi
D |  |  |  |  |  |  |  |  |  |  |  |  |  |  |  |  |  |  |  |  |  |  | TWE-Lite | TWE_LITE_SMD |  |  | 3 | DO1 | output
D |  |  |  |  |  |  |  |  |  |  |  |  |  |  |  |  |  |  |  |  |  |  | TWE-Lite | TWE_LITE_SMD |  |  | 4 | DO2 | output
D |  |  |  |  |  |  |  |  |  |  |  |  |  |  |  |  |  |  |  |  |  |  | TWE-Lite | TWE_LITE_SMD |  |  | 5 | VCC | power_in
D |  |  |  |  |  |  |  |  |  |  |  |  |  |  |  |  |  |  |  |  |  |  | TWE-Lite | TWE_LITE_SMD |  |  | 6 | DO3 | output
D |  |  |  |  |  |  |  |  |  |  |  |  |  |  |  |  |  |  |  |  |  |  | TWE-Lite | TWE_LITE_SMD |  |  | 7 | PWM1 | output
D |  |  |  |  |  |  |  |  |  |  |  |  |  |  |  |  |  |  |  |  |  |  | TWE-Lite | TWE_LITE_SMD |  |  | 8 | TX | output
D |  |  |  |  |  |  |  |  |  |  |  |  |  |  |  |  |  |  |  |  |  |  | TWE-Lite | TWE_LITE_SMD |  |  | 9 | RX | input
D |  |  |  |  |  |  |  |  |  |  |  |  |  |  |  |  |  |  |  |  |  |  | TWE-Lite | TWE_LITE_SMD |  |  | 10 | PWM4 | output
D |  |  |  |  |  |  |  |  |  |  |  |  |  |  |  |  |  |  |  |  |  |  | TWE-Lite | TWE_LITE_SMD |  |  | 11 | DO4 | output
D |  |  |  |  |  |  |  |  |  |  |  |  |  |  |  |  |  |  |  |  |  |  | TWE-Lite | TWE_LITE_SMD |  |  | 12 | M1 | input
D |  |  |  |  |  |  |  |  |  |  |  |  |  |  |  |  |  |  |  |  |  |  | TWE-Lite | TWE_LITE_SMD |  |  | 13 | DI1 | input
D |  |  |  |  |  |  |  |  |  |  |  |  |  |  |  |  |  |  |  |  |  |  | TWE-Lite | TWE_LITE_SMD |  |  | 14 | SCL | BiDi
D |  |  |  |  |  |  |  |  |  |  |  |  |  |  |  |  |  |  |  |  |  |  | TWE-Lite | TWE_LITE_SMD |  |  | 15 | DI2 | input
D |  |  |  |  |  |  |  |  |  |  |  |  |  |  |  |  |  |  |  |  |  |  | TWE-Lite | TWE_LITE_SMD |  |  | 16 | DI3 | input
D |  |  |  |  |  |  |  |  |  |  |  |  |  |  |  |  |  |  |  |  |  |  | TWE-Lite | TWE_LITE_SMD |  |  | 17 | SDA | BiDi
D |  |  |  |  |  |  |  |  |  |  |  |  |  |  |  |  |  |  |  |  |  |  | TWE-Lite | TWE_LITE_SMD |  |  | 18 | DI4 | input
D |  |  |  |  |  |  |  |  |  |  |  |  |  |  |  |  |  |  |  |  |  |  | TWE-Lite | TWE_LITE_SMD |  |  | 19 | BPS | input
D |  |  |  |  |  |  |  |  |  |  |  |  |  |  |  |  |  |  |  |  |  |  | TWE-Lite | TWE_LITE_SMD |  |  | 20 | GND | power_in
D |  |  |  |  |  |  |  |  |  |  |  |  |  |  |  |  |  |  |  |  |  |  | TWE-Lite | TWE_LITE_SMD |  |  | 21 | RST# | input
D |  |  |  |  |  |  |  |  |  |  |  |  |  |  |  |  |  |  |  |  |  |  | TWE-Lite | TWE_LITE_SMD |  |  | 22 | AI3 | input
D |  |  |  |  |  |  |  |  |  |  |  |  |  |  |  |  |  |  |  |  |  |  | TWE-Lite | TWE_LITE_SMD |  |  | 23 | AI1 | input
D |  |  |  |  |  |  |  |  |  |  |  |  |  |  |  |  |  |  |  |  |  |  | TWE-Lite | TWE_LITE_SMD |  |  | 24 | AI2 | input
D |  |  |  |  |  |  |  |  |  |  |  |  |  |  |  |  |  |  |  |  |  |  | TWE-Lite | TWE_LITE_SMD |  |  | 25 | AI4 | input
D |  |  |  |  |  |  |  |  |  |  |  |  |  |  |  |  |  |  |  |  |  |  | TWE-Lite | TWE_LITE_SMD |  |  | 26 | M2 | input
D |  |  |  |  |  |  |  |  |  |  |  |  |  |  |  |  |  |  |  |  |  |  | TWE-Lite | TWE_LITE_SMD |  |  | 27 | M3 | input
D |  |  |  |  |  |  |  |  |  |  |  |  |  |  |  |  |  |  |  |  |  |  | TWE-Lite | TWE_LITE_SMD |  |  | 28 | GND | power_in
D |  |  |  |  |  |  |  |  |  |  |  |  |  |  |  |  |  |  |  |  |  |  | TWE-Lite | TWE_LITE_SMD |  |  | 29 | NC | NotConnected
D |  |  |  |  |  |  |  |  |  |  |  |  |  |  |  |  |  |  |  |  |  |  | TWE-Lite | TWE_LITE_SMD |  |  | 30 | GND | power_in
D |  |  |  |  |  |  |  |  |  |  |  |  |  |  |  |  |  |  |  |  |  |  | TWE-Lite | TWE_LITE_SMD |  |  | 31 | GND | power_in
D |  |  |  |  |  |  |  |  |  |  |  |  |  |  |  |  |  |  |  |  |  |  | TWE-Lite | TWE_LITE_SMD |  |  | 32 | GND | power_in
D |  |  |  |  |  |  |  |  |  |  |  |  |  |  |  |  |  |  |  |  |  |  | mylib_CanSat | microSD | U | Reference
D |  |  |  |  |  |  |  |  |  |  |  |  |  |  |  |  |  |  |  |  |  |  | mylib_CanSat | microSD | microSD | Value
D |  |  |  |  |  |  |  |  |  |  |  |  |  |  |  |  |  |  |  |  |  |  | mylib_CanSat | microSD |  |  | 1 | DAT2 | BiDi
D |  |  |  |  |  |  |  |  |  |  |  |  |  |  |  |  |  |  |  |  |  |  | mylib_CanSat | microSD |  |  | 2 | CD/DAT3 | BiDi
D |  |  |  |  |  |  |  |  |  |  |  |  |  |  |  |  |  |  |  |  |  |  | mylib_CanSat | microSD |  |  | 3 | CMD | input
D |  |  |  |  |  |  |  |  |  |  |  |  |  |  |  |  |  |  |  |  |  |  | mylib_CanSat | microSD |  |  | 4 | VDD | power_in
D |  |  |  |  |  |  |  |  |  |  |  |  |  |  |  |  |  |  |  |  |  |  | mylib_CanSat | microSD |  |  | 5 | CLK | input
D |  |  |  |  |  |  |  |  |  |  |  |  |  |  |  |  |  |  |  |  |  |  | mylib_CanSat | microSD |  |  | 6 | VSS | power_in
D |  |  |  |  |  |  |  |  |  |  |  |  |  |  |  |  |  |  |  |  |  |  | mylib_CanSat | microSD |  |  | 7 | DAT0 | BiDi
D |  |  |  |  |  |  |  |  |  |  |  |  |  |  |  |  |  |  |  |  |  |  | mylib_CanSat | microSD |  |  | 8 | DAT1 | BiDi
D |  |  |  |  |  |  |  |  |  |  |  |  |  |  |  |  |  |  |  |  |  |  | mylib_CanSat | microSD |  |  | 9 | CARDDETECT | passive
D |  |  |  |  |  |  |  |  |  |  |  |  |  |  |  |  |  |  |  |  |  |  | mylib_CanSat | microSD |  |  | 10 | GROUND | passive
D |  |  |  |  |  |  |  |  |  |  |  |  |  |  |  |  |  |  |  |  |  |  |  |  |  |  |  |  |  |  |  |  |  | mylib_CanSat | mylib_CanSat.lib
D |  |  |  |  |  |  |  |  |  |  |  |  |  |  |  |  |  |  |  |  |  |  |  |  |  |  |  |  |  |  |  |  |  | WRPJ | WRPJ.lib
D |  |  |  |  |  |  |  |  |  |  |  |  |  |  |  |  |  |  |  |  |  |  |  |  |  |  |  |  |  |  |  |  |  | STM32 | D:\KiCad\share\kicad\library\STM32.lib
D |  |  |  |  |  |  |  |  |  |  |  |  |  |  |  |  |  |  |  |  |  |  |  |  |  |  |  |  |  |  |  |  |  | regul | D:\KiCad\share\kicad\library\regul.lib
D |  |  |  |  |  |  |  |  |  |  |  |  |  |  |  |  |  |  |  |  |  |  |  |  |  |  |  |  |  |  |  |  |  | TWE-Lite | D:\KiCad\share\kicad\user_library\TWE-Lite.lib
D |  |  |  |  |  |  |  |  |  |  |  |  |  |  |  |  |  |  |  |  |  |  |  |  |  |  |  |  |  |  |  |  |  | user_library | D:\KiCad\share\kicad\user_library\user_library.lib
D |  |  |  |  |  |  |  |  |  |  |  |  |  |  |  |  |  |  |  |  |  |  |  |  |  |  |  |  |  |  |  |  |  | WRPJ_Ver4.0-cache | D:\OneDrive\2017能代宇宙イベント\水ロケット\Ver4.0\WRPJ_Ver4.0-cache.lib
D |  |  |  |  |  |  |  |  |  |  |  |  |  |  |  |  |  |  |  |  |  |  |  |  |  |  |  |  |  |  |  |  |  | linear | D:\KiCad\share\kicad\library\linear.lib
D |  |  |  |  |  |  |  |  |  |  |  |  |  |  |  |  |  |  |  |  |  |  |  |  |  |  |  |  |  |  |  |  |  | conn | D:\KiCad\share\kicad\library\conn.lib
D |  |  |  |  |  |  |  |  |  |  |  |  |  |  |  |  |  |  |  |  |  |  |  |  |  |  |  |  |  |  |  |  |  | WRPJ_Ver4.0-rescue | WRPJ_Ver4.0-rescue.lib
D |  |  |  |  |  |  |  |  |  |  |  |  |  |  |  |  |  |  |  |  |  |  |  |  |  |  |  |  |  |  |  |  |  | device | D:\KiCad\share\kicad\library\device.lib
D |  |  |  |  |  |  |  |  |  |  |  |  |  |  |  |  |  |  |  |  |  |  |  |  |  |  |  |  |  |  |  |  |  |  |  | 1 | Net-(IC1-Pad30) | P3 | 1
D |  |  |  |  |  |  |  |  |  |  |  |  |  |  |  |  |  |  |  |  |  |  |  |  |  |  |  |  |  |  |  |  |  |  |  | 1 | Net-(IC1-Pad30) | IC1 | 30
D |  |  |  |  |  |  |  |  |  |  |  |  |  |  |  |  |  |  |  |  |  |  |  |  |  |  |  |  |  |  |  |  |  |  |  | 1 | Net-(IC1-Pad30) | R18 | 2
D |  |  |  |  |  |  |  |  |  |  |  |  |  |  |  |  |  |  |  |  |  |  |  |  |  |  |  |  |  |  |  |  |  |  |  | 2 | /BUS_VCC | R18 | 1
D |  |  |  |  |  |  |  |  |  |  |  |  |  |  |  |  |  |  |  |  |  |  |  |  |  |  |  |  |  |  |  |  |  |  |  | 2 | /BUS_VCC | U3 | 2
D |  |  |  |  |  |  |  |  |  |  |  |  |  |  |  |  |  |  |  |  |  |  |  |  |  |  |  |  |  |  |  |  |  |  |  | 2 | /BUS_VCC | R22 | 1
D |  |  |  |  |  |  |  |  |  |  |  |  |  |  |  |  |  |  |  |  |  |  |  |  |  |  |  |  |  |  |  |  |  |  |  | 2 | /BUS_VCC | IC1 | 20
D |  |  |  |  |  |  |  |  |  |  |  |  |  |  |  |  |  |  |  |  |  |  |  |  |  |  |  |  |  |  |  |  |  |  |  | 2 | /BUS_VCC | R19 | 1
D |  |  |  |  |  |  |  |  |  |  |  |  |  |  |  |  |  |  |  |  |  |  |  |  |  |  |  |  |  |  |  |  |  |  |  | 2 | /BUS_VCC | C6 | 1
D |  |  |  |  |  |  |  |  |  |  |  |  |  |  |  |  |  |  |  |  |  |  |  |  |  |  |  |  |  |  |  |  |  |  |  | 2 | /BUS_VCC | U6 | 7
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
D |  |  |  |  |  |  |  |  |  |  |  |  |  |  |  |  |  |  |  |  |  |  |  |  |  |  |  |  |  |  |  |  |  |  |  | 105 | Net-(U7-Pad11) | U7 | 11
D |  |  |  |  |  |  |  |  |  |  |  |  |  |  |  |  |  |  |  |  |  |  |  |  |  |  |  |  |  |  |  |  |  |  |  | 106 | Net-(U7-Pad21) | U7 | 21
D |  |  |  |  |  |  |  |  |  |  |  |  |  |  |  |  |  |  |  |  |  |  |  |  |  |  |  |  |  |  |  |  |  |  |  | 107 | Net-(U7-Pad22) | U7 | 22
D |  |  |  |  |  |  |  |  |  |  |  |  |  |  |  |  |  |  |  |  |  |  |  |  |  |  |  |  |  |  |  |  |  |  |  | 108 | Net-(U7-Pad13) | U7 | 13
D |  |  |  |  |  |  |  |  |  |  |  |  |  |  |  |  |  |  |  |  |  |  |  |  |  |  |  |  |  |  |  |  |  |  |  | 109 | /LiPo_Isens | R11 | 2
D |  |  |  |  |  |  |  |  |  |  |  |  |  |  |  |  |  |  |  |  |  |  |  |  |  |  |  |  |  |  |  |  |  |  |  | 109 | /LiPo_Isens | U1 | 6
D |  |  |  |  |  |  |  |  |  |  |  |  |  |  |  |  |  |  |  |  |  |  |  |  |  |  |  |  |  |  |  |  |  |  |  | 109 | /LiPo_Isens | U1 | 7
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
