yosihisa/WaterRocketComputerVer4/基板/製造ファイル/WRPJ_Ver4.0_BOM.xlsx

Parts | Value | package | QTY | DigiKey/Mouser/Manufacturer part | Elecrow PN | Component ID | Component Part Number | Digi-Key Part Number | Remark/Link
C1,C2,C3,C4,C5,C6,C7,C11,C12,C13,C14,C15,C16,C17 | 0.1uF | 0603 | 14 | Elecrow 364 Free Compoents |  | 15331 | C14663
C10 | 2.2uF | 0603 | 1 | Elecrow 365 Free Compoents |  | 24366 | C23630
R5,R6 | 100Ω | 0603 | 2 | Elecrow 366 Free Compoents |  | 23502 | C22775
R7,R8,R10,R11,R12,R13,R14,R15,R28,R29 | 1kΩ | 0603 | 10 | Elecrow 367 Free Compoents |  | 21904 | C21190
R26,R27 | 4.7kΩ | 0603 | 2 | Elecrow 368 Free Compoents |  | 23889 | C23162
R1,R2,R3,R9,R16,R17,R18,R19,R20,R21,R22,R23,R24,R25 | 10kΩ | 0603 | 14 | Elecrow 369 Free Compoents |  | 26547 | C25804
IC1 | ATMEGA328P-AU | 32-TQFP | 1 | Elecrow | 5020532A
U6 | AT25SF041-SSHD-B | 8-SOIC | 1 | DigiKey |  |  |  | 1265-1174-5-ND | https://www.digikey.jp/product-detail/ja/adesto-technologies/AT25SF041-SSHD-B/1265-1174-5-ND/4901550
U8 | STM32F401RCTx | 64-LQFP | 1 | DigiKey |  |  |  | 497-14047-ND | https://www.digikey.jp/product-detail/ja/stmicroelectronics/STM32F401RCT6/497-14047-ND/4494300
U9 | MPU-9250 | 24-QFN | 1 | DigiKey |  |  |  | 1428-1019-1-ND | https://www.digikey.jp/product-detail/ja/tdk-invensense/MPU-9250/1428-1019-1-ND/4626450
U11 | ADXL375 | 14-VFLGA | 1 | DigiKey |  |  |  | ADXL375BCCZ-RL7CT-ND | https://www.digikey.jp/product-detail/ja/analog-devices-inc/ADXL375BCCZ-RL7/ADXL375BCCZ-RL7CT-ND/4376405
U12 | LPS25HB | 10-VFLGA | 1 | DigiKey |  |  |  | 497-15070-1-ND | https://www.digikey.jp/product-detail/ja/stmicroelectronics/LPS25HBTR/497-15070-1-ND/5043076
