yosihisa/WaterRocketComputerVer4/基板/製造ファイル/WRPJ_Ver4.0.pdf

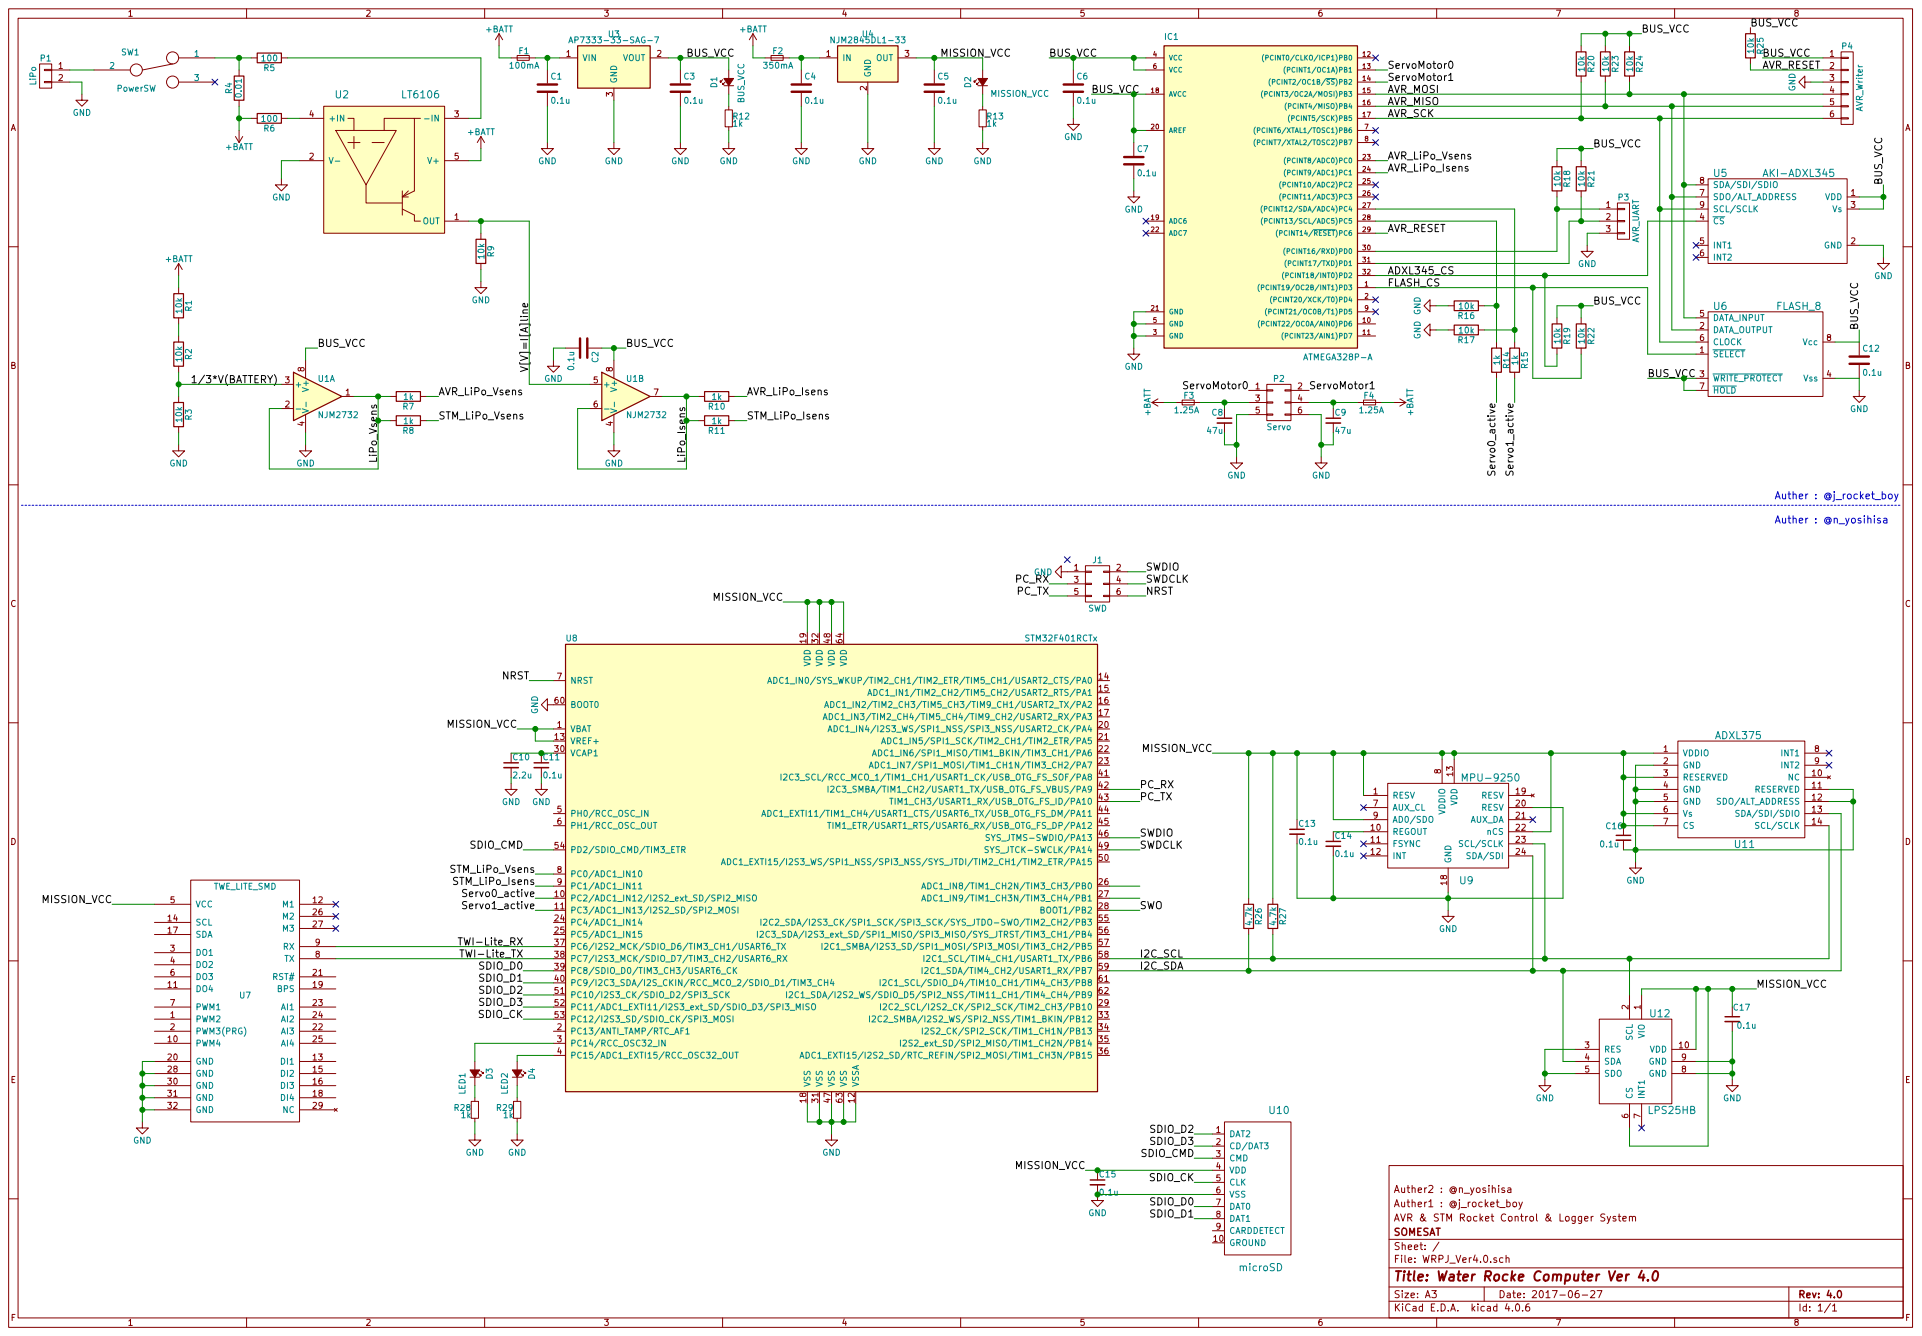
[picture p9: page 1]

8 AD0/SDO 9 REGOUT 10 RESV 20 FSYNC 11 AUX_DA 21

2 RES 3 SDA 4 SDO 5 CS

Auther2 : @n_yosihisa
Auther1 : @j_rocket_boy
File: WRPJ_Ver4.0.sch Sheet: / SOMESAT AVR & STM Rocket Control & Logger System

Id: 1/1 Title: Water Rocke Computer Ver 4.0
