yosihisa/WaterRocketComputerVer4/基板/WRPJ_Ver4.0.kicad_pcb

## KiCad design 基板/WRPJ_Ver4.0.kicad_pcb (2017-08-11)

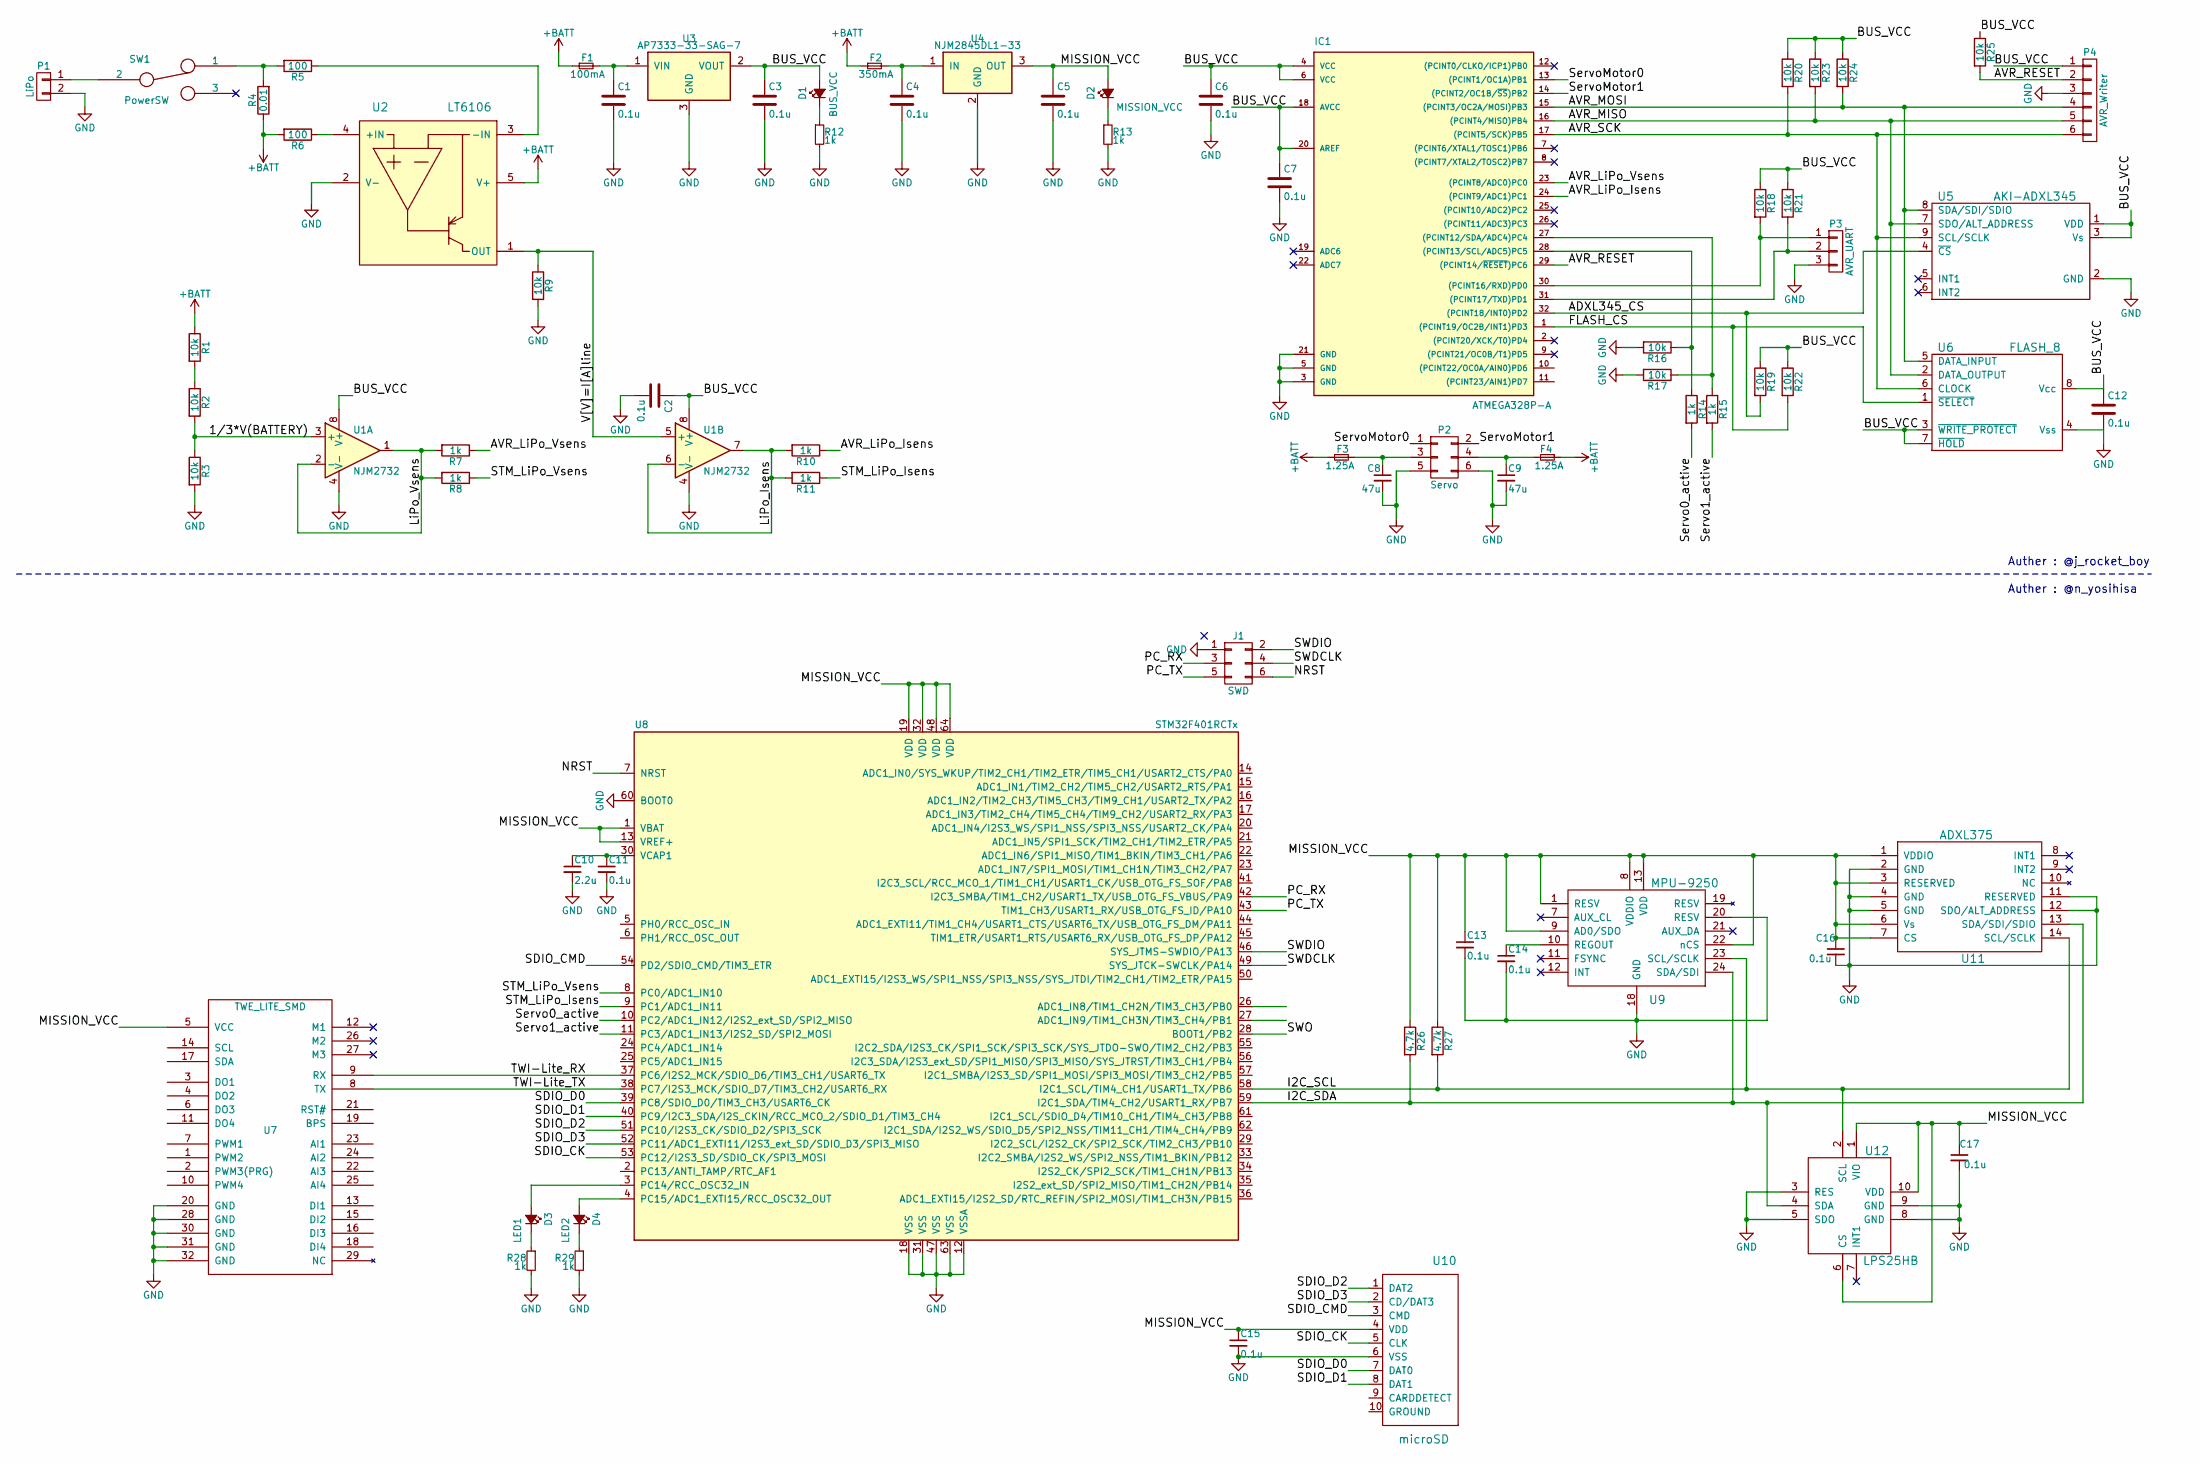
[picture p10: schematic WRPJ_Ver4.0.sch, Water Rocke Computer Ver 4.0]

Parts:
C1, C2, C3, C4, C5, C6, C7, C11, C12, C13, C14, C15, C16, C17: 0.1u; C_0603
C8, C9: 47u; C_1210
C10: 2.2u; C_0603
D1: BUS_VCC; LED_0603
D2: MISSION_VCC; LED_0603
D3: LED1; LED_0603
D4: LED2; LED_0603
F1: 100mA; R_1210
F2: 350mA; R_1210
F3, F4: 1.25A; R_1210
IC1: ATMEGA328P-A; LQFP-32_7x7mm_Pitch0.8mm
J1: SWD; Pin_Header_Straight_2x03_Pitch1.27mm
P1: LiPo; S2B-EH
P2: Servo; Pin_Header_Angled_2x03_Pitch2.54mm
P3: AVR_UART; Pin_Header_Straight_1x03_Pitch1.27mm
P4: AVR_Writer; Pin_Header_Straight_1x06_Pitch1.27mm
R1, R2, R3, R9, R16, R17, R18, R19, R20, R21, R22, R23, R24, R25: 10k; R_0603
R4: 0.01; R_2512
R5, R6: 100; R_0603
R7, R8, R10, R11, R12, R13, R14, R15, R28, R29: 1k; R_0603
R26, R27: 4.7k; R_0603
SW1: PowerSW; SS-12D01-VG4
U1: NJM2732; SSOP-8
U2: LT6106; SOT-23-5
U3: AP7333-33-SAG-7; SOT-23
U4: NJM2845DL1-33; TO-252-2
U5: AKI-ADXL345
U6: FLASH_8; SOIC-8-N
U7: TWE_LITE_SMD; TWE-001L-SMD
U8: STM32F401RCTx; LQFP-64_10x10mm_Pitch0.5mm
U9: MPU-9250; QFN-24_3x3mm_Pitch0.4mm
U10: microSD
U11: ADXL375; LGA_CC-14-1
U12: LPS25HB; HLGA-10L

Connections:
+BATT: F1.1, F2.1, F3.1, F4.1, R1.1, R4.1, R6.2, U2.5 (V+)
/1/3*V(BATTERY): R2.2, R3.1, U1.3 (+)
/ADXL345_CS: IC1.32 ((PCINT18/INT0)PD2), R19.2, U5.4 (~CS)
/AVR_LiPo_Isens: IC1.24 ((PCINT9/ADC1)PC1), R10.1
/AVR_LiPo_Vsens: IC1.23 ((PCINT8/ADC0)PC0), R7.1
/AVR_MISO: IC1.16 ((PCINT4/MISO)PB4), P4.5, R23.2, U5.7 (SDO/ALT_ADDRESS), U6.2 (DATA_OUTPUT)
/AVR_MOSI: IC1.15 ((PCINT3/OC2A/MOSI)PB3), P4.4, R24.2, U5.8 (SDA/SDI/SDIO), U6.5 (DATA_INPUT)
/AVR_RESET: IC1.29 ((PCINT14/~RESET~)PC6), P4.2, R25.2
/AVR_SCK: IC1.17 ((PCINT5/SCK)PB5), P4.6, R20.2, U5.9 (SCL/SCLK), U6.6 (CLOCK)
/BUS_VCC: C2.1, C3.1, C6.1, C7.1, C12.1, D1.2 (A), IC1.4 (VCC), IC1.6 (VCC), IC1.18 (AVCC), IC1.20 (AREF), P4.1, R18.1, R19.1, R20.1, R21.1, R22.1, R23.1, R24.1, R25.1, U1.8 (V+), U3.2 (VOUT), U5.1 (VDD), U5.3 (Vs), U6.3 (~WRITE_PROTECT), U6.7 (~HOLD), U6.8 (Vcc)
/FLASH_CS: IC1.1 ((PCINT19/OC2B/INT1)PD3), R22.2, U6.1 (~SELECT)
/I2C_SCL: R27.2, U8.58 (I2C1_SCL/TIM4_CH1/USART1_TX/PB6), U9.23 (SCL/SCLK), U11.14 (SCL/SCLK), U12.2 (SCL)
/I2C_SDA: R26.2, U8.59 (I2C1_SDA/TIM4_CH2/USART1_RX/PB7), U9.24 (SDA/SDI), U11.13 (SDA/SDI/SDIO), U12.4 (SDA)
/LiPo_Isens: R10.2, R11.2, U1.6 (-), U1.7
/LiPo_Vsens: R7.2, R8.2, U1.1, U1.2 (-)
/MISSION_VCC: C5.1, C13.1, C15.1, C16.1, C17.1, D2.2 (A), R26.1, R27.1, U4.3 (OUT), U7.5 (VCC), U8.1 (VBAT), U8.13 (VREF+), U8.19 (VDD), U8.32 (VDD), U8.48 (VDD), U8.64 (VDD), U9.1 (RESV), U9.8 (VDDIO), U9.9 (AD0/SDO), U9.13 (VDD), U9.22 (nCS), U10.4 (VDD), U11.1 (VDDIO), U11.3 (RESERVED), U11.6 (Vs), U11.7 (CS), U12.1 (VIO), U12.6 (CS), U12.10 (VDD)
/NRST: J1.6, U8.7 (NRST)
/PC_RX: J1.3, U8.42 (I2C3_SMBA/TIM1_CH2/USART1_TX/USB_OTG_FS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)
/PC_TX: J1.5, U8.43 (TIM1_CH3/USART1_RX/USB_OTG_FS_ID/PA10)
/SDIO_CK: U8.53 (PC12/I2S3_SD/SDIO_CK/SPI3_MOSI), U10.5 (CLK)
/SDIO_CMD: U8.54 (PD2/SDIO_CMD/TIM3_ETR), U10.3 (CMD)
/SDIO_D0: U8.39 (PC8/SDIO_D0/TIM3_CH3/USART6_CK), U10.7 (DAT0)
/SDIO_D1: U8.40 (PC9/I2C3_SDA/I2S_CKIN/RCC_MCO_2/SDIO_D1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), U10.8 (DAT1)
/SDIO_D2: U8.51 (PC10/I2S3_CK/SDIO_D2/SPI3_SCK), U10.1 (DAT2)
/SDIO_D3: U8.52 (PC11/ADC1_EXTI11/I2S3_ext_SD/SDIO_D3/SP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), U10.2 (CD/DAT3)
/STM_LiPo_Isens: R11.1, U8.9 (PC1/ADC1_IN11)
/STM_LiPo_Vsens: R8.1, U8.8 (PC0/ADC1_IN10)
/SWDCLK: J1.4, U8.49 (SYS_JTCK-SWCLK/PA14)
/SWDIO: J1.2, U8.46 (SYS_JTMS-SWDIO/PA13)
/SWO: U8.28 (BOOT1/PB2)
/Servo0_active: R14.2, U8.10 (PC2/ADC1_IN12/I2S2_ext_SD/SPI2_MISO)
/Servo1_active: R15.2, U8.11 (PC3/ADC1_IN13/I2S2_SD/SPI2_MOSI)
/ServoMotor0: IC1.13 ((PCINT1/OC1A)PB1), P2.1
/ServoMotor1: IC1.14 ((PCINT2/OC1B/~SS~)PB2), P2.2
/TWI-Lite_RX: U7.9 (RX), U8.37 (PC6/I2S2_MCK/SDIO_D6/TIM3_CH1/USART6_TX)
/TWI-Lite_TX: U7.8 (TX), U8.38 (PC7/I2S3_MCK/SDIO_D7/TIM3_CH2/USART6_RX)
/V[V]=I[A]line: R9.1, U1.5 (+), U2.1 (OUT)
GND: C1.2, C2.2, C3.2, C4.2, C5.2, C6.2, C7.2, C8.2, C9.2, C10.2, C11.2, C12.2, C13.2, C14.2, C15.2, C16.2, C17.2, IC1.3 (GND), IC1.5 (GND), IC1.21 (GND), J1.1, P1.2, P2.5, P2.6, P3.3, P4.3, R3.2, R9.2, R12.2, R13.2, R16.2, R17.2, R28.2, R29.2, U1.4 (V-), U2.2 (V-), U3.3 (GND), U4.2 (GND), U5.2 (GND), U6.4 (Vss), U7.20 (GND), U7.28 (GND), U7.30 (GND), U7.31 (GND), U7.32 (GND), U8.12 (VSSA), U8.18 (VSS), U8.31 (VSS), U8.47 (VSS), U8.60 (BOOT0), U8.63 (VSS), U9.18 (GND), U9.20 (RESV), U10.6 (VSS), U11.2 (GND), U11.4 (GND), U11.5 (GND), U11.11 (RESERVED), U11.12 (SDO/ALT_ADDRESS), U12.3 (RES), U12.5 (SDO), U12.8 (GND), U12.9 (GND)
unnamed: C1.1, F1.2, U3.1 (VIN)
unnamed: C4.1, F2.2, U4.1 (IN)
unnamed: C8.1, F3.2, P2.3
unnamed: C9.1, F4.2, P2.4
unnamed: C10.1, C11.1, U8.30 (VCAP1)
unnamed: C14.1, U9.10 (REGOUT)
unnamed: D1.1 (K), R12.1
unnamed: D2.1 (K), R13.1
unnamed: D3.1 (K), R28.1
unnamed: D3.2 (A), U8.3 (PC14/RCC_OSC32_IN)
unnamed: D4.1 (K), R29.1
unnamed: D4.2 (A), U8.4 (PC15/ADC1_EXTI15/RCC_OSC32_OUT)
unnamed: IC1.27 ((PCINT12/SDA/ADC4)PC4), R15.1, R17.1
unnamed: IC1.28 ((PCINT13/SCL/ADC5)PC5), R14.1, R16.1
unnamed: IC1.30 ((PCINT16/RXD)PD0), P3.1, R18.2
unnamed: IC1.31 ((PCINT17/TXD)PD1), P3.2, R21.2
unnamed: P1.1, SW1.2
unnamed: R1.2, R2.1
unnamed: R4.2, R5.2, SW1.1
unnamed: R5.1, U2.3 (-IN)
unnamed: R6.1, U2.4 (+IN)

Notes on the sheet:
Auther : @j_rocket_boy
Auther : @n_yosihisa

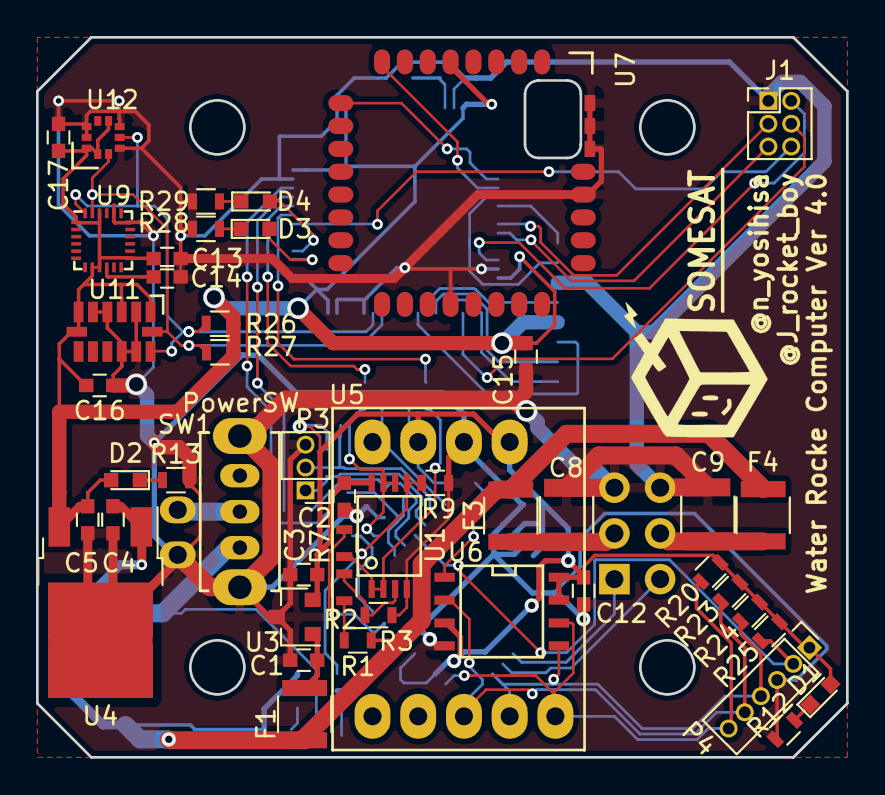
[picture p11: board WRPJ_Ver4.0.kicad_pcb from above]

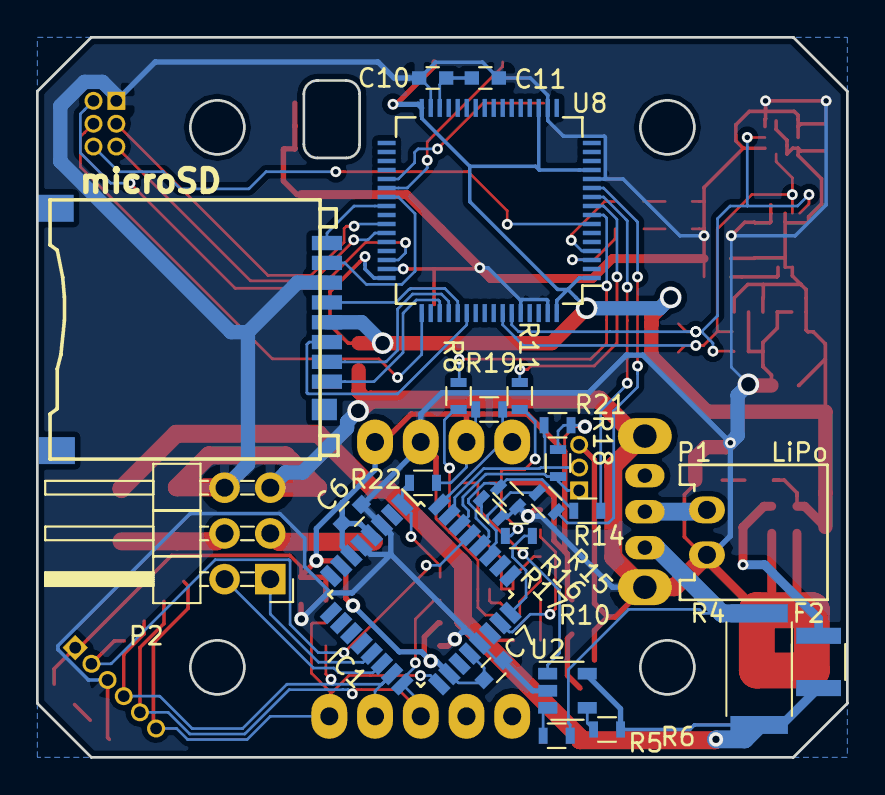
[picture p12: board WRPJ_Ver4.0.kicad_pcb from below]

Board: 2 copper layers, 45.0 x 40.0 mm, 73 parts (24 on the bottom side), 58 nets.
