yosihisa/WaterRocketComputerVer4/WRC.ioc

Mcu.UserName=STM32F401RCTx
PA10.Signal=USART1_RX
PA13.Signal=SYS_JTMS-SWDIO
PA14.Signal=SYS_JTCK-SWCLK
PA9.Signal=USART1_TX
PB6.Signal=I2C1_SCL
PB7.Signal=I2C1_SDA
PC0.Signal=ADCx_IN10
PC1.Signal=ADCx_IN11
PC10.Signal=SDIO_D2
PC11.Signal=SDIO_D3
PC12.Signal=SDIO_CK
PC14-OSC32_IN.GPIO_Label=LED1
PC14-OSC32_IN.Signal=GPIO_Output
PC15-OSC32_OUT.GPIO_Label=LED2
PC15-OSC32_OUT.Signal=GPIO_Output
PC2.GPIO_Label=Servo0
PC2.Signal=GPIO_Input
PC3.GPIO_Label=Servo1
PC3.Signal=GPIO_Input
PC6.Signal=USART6_TX
PC7.Signal=USART6_RX
PC8.Signal=SDIO_D0
PC9.Signal=SDIO_D1
PD2.Signal=SDIO_CMD
