yosihisa/WaterRocketComputerVer4/(notices)

Notices in the files:
Src/main.c:
(C) COPYRIGHT STMicroelectronics *****END OF FILE
